Mr-A-urora/mini_wheel_legged_four/finished/主控陀螺仪校准.docx

1. Type_c连接主控,打开串口上位机（波特率随意）
2. 主控水平静止放置
3. 串口发送 imu set
4. 串口返回六个数据
5. 将六个数据复制粘贴到主控代码里

粘贴位置：Core\Work\BSP\BMI088\BMI088driver.h

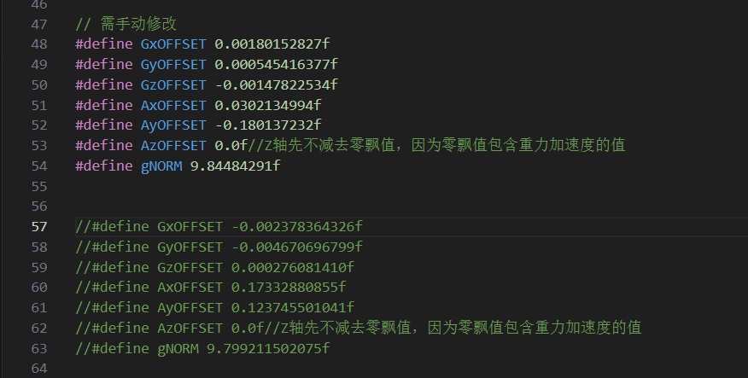
[picture p3: figure]
