Mr-A-urora/mini_wheel_legged_four/finished/hardware/主控.jpeg

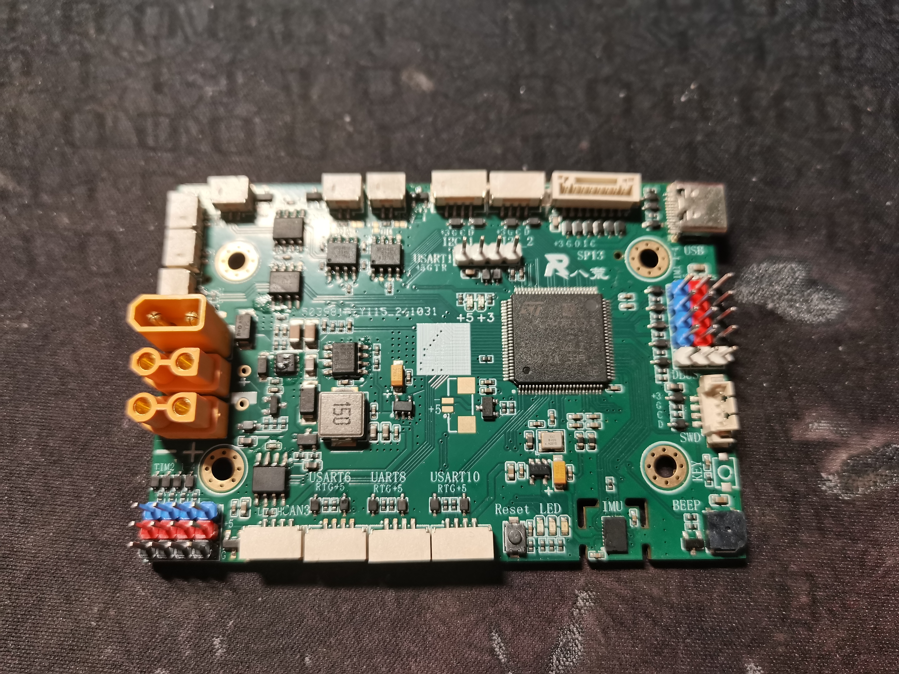
finished/hardware/主控.jpeg
