Mr-A-urora/mini_wheel_legged_four/finished/hardware/遥控器接收机.jpg

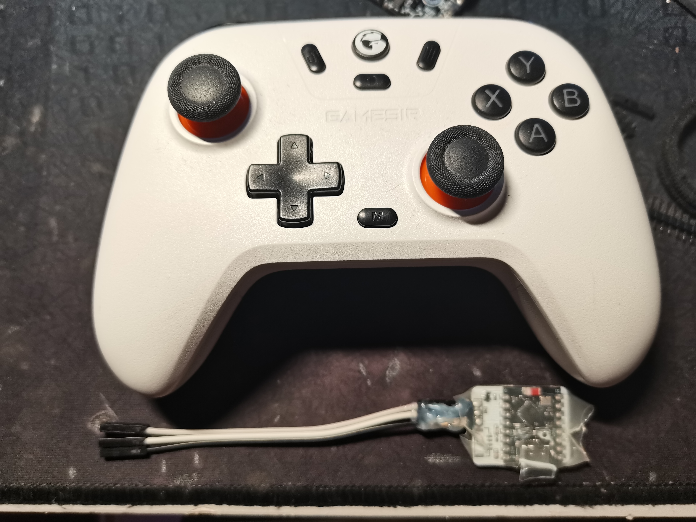
finished/hardware/遥控器接收机.jpg
