Mr-A-urora/mini_wheel_legged_four/finished/software/picture/imu_check.jpg

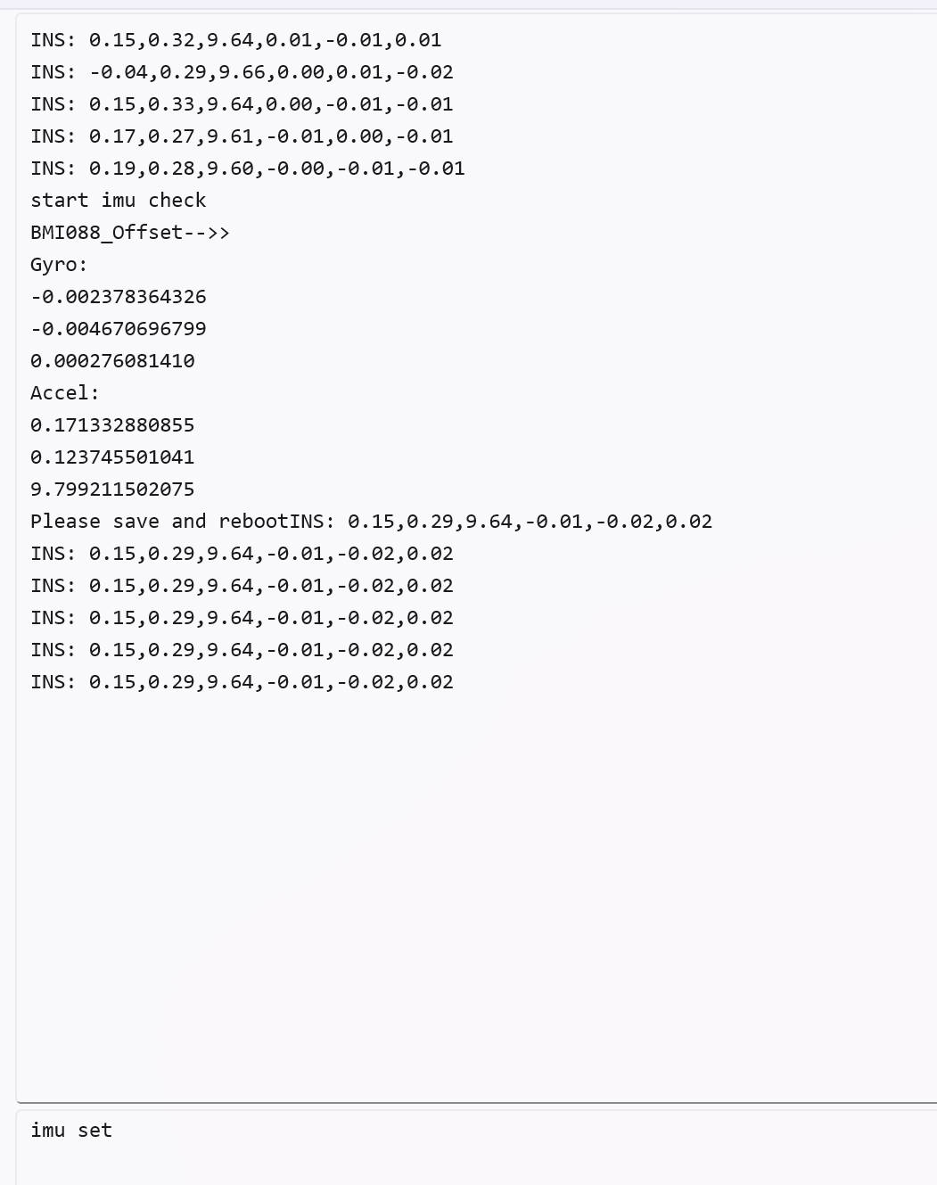
finished/software/picture/imu_check.jpg
