Mr-A-urora/mini_wheel_legged_four/finished/software/picture/Joint_Motor.jpg

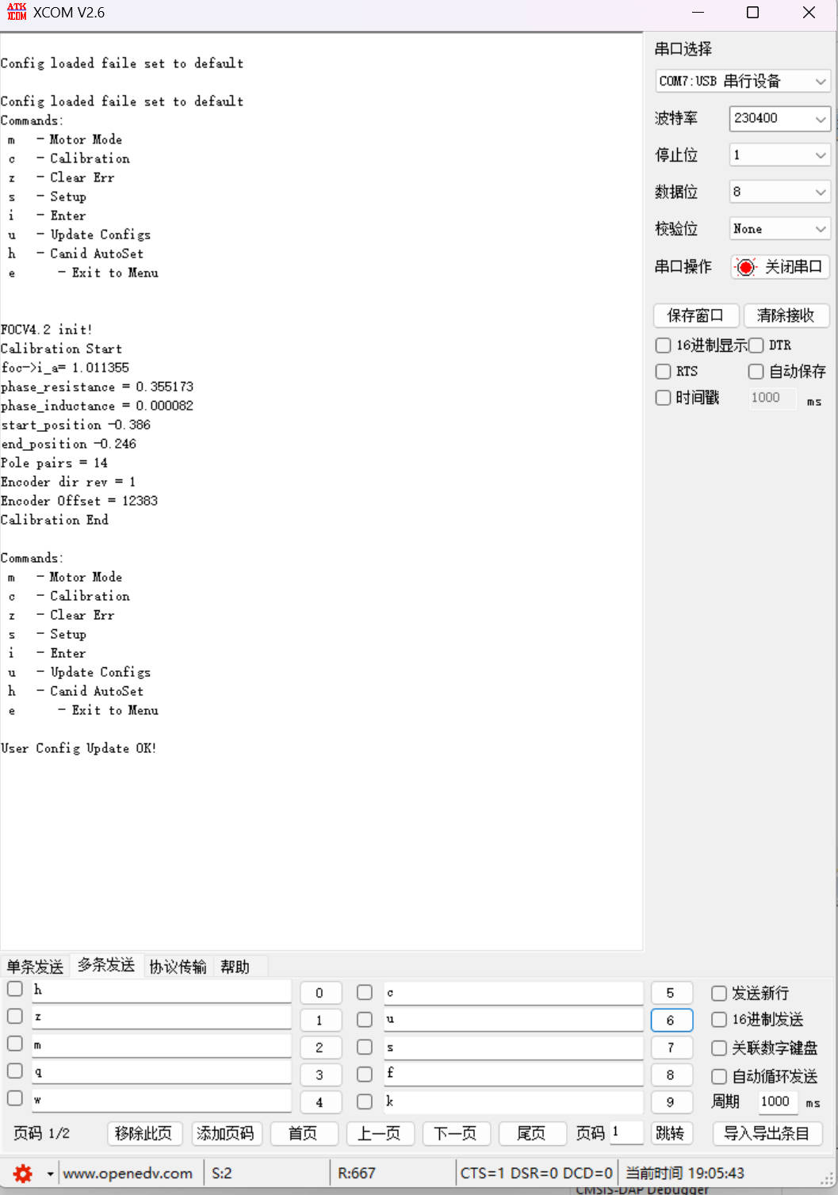
finished/software/picture/Joint_Motor.jpg
