Mr-A-urora/mini_wheel_legged_four/finished/software/Webots_word/worlds/.miniBH3.jpg

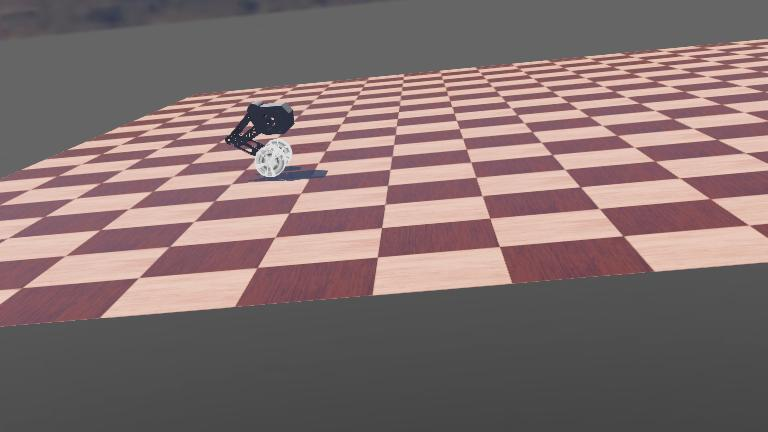
finished/software/Webots_word/worlds/.miniBH3.jpg
