Mr-A-urora/mini_wheel_legged_four/finished/机械/汽车兔.jpg

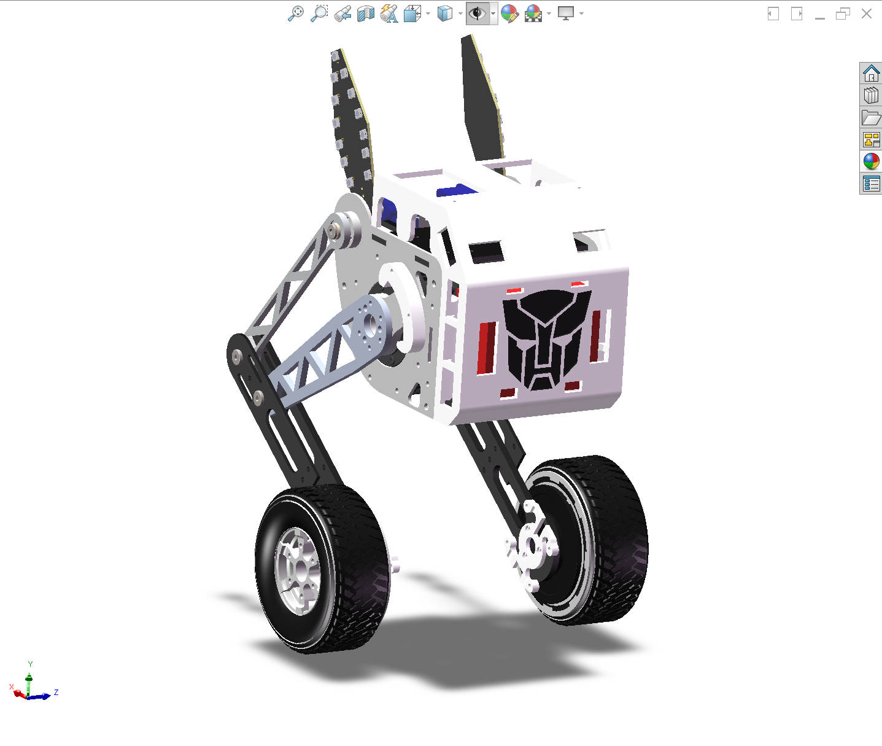
finished/机械/汽车兔.jpg
