Mr-A-urora/mini_wheel_legged_four/微信图片_2026-07-05_232406_757.jpg

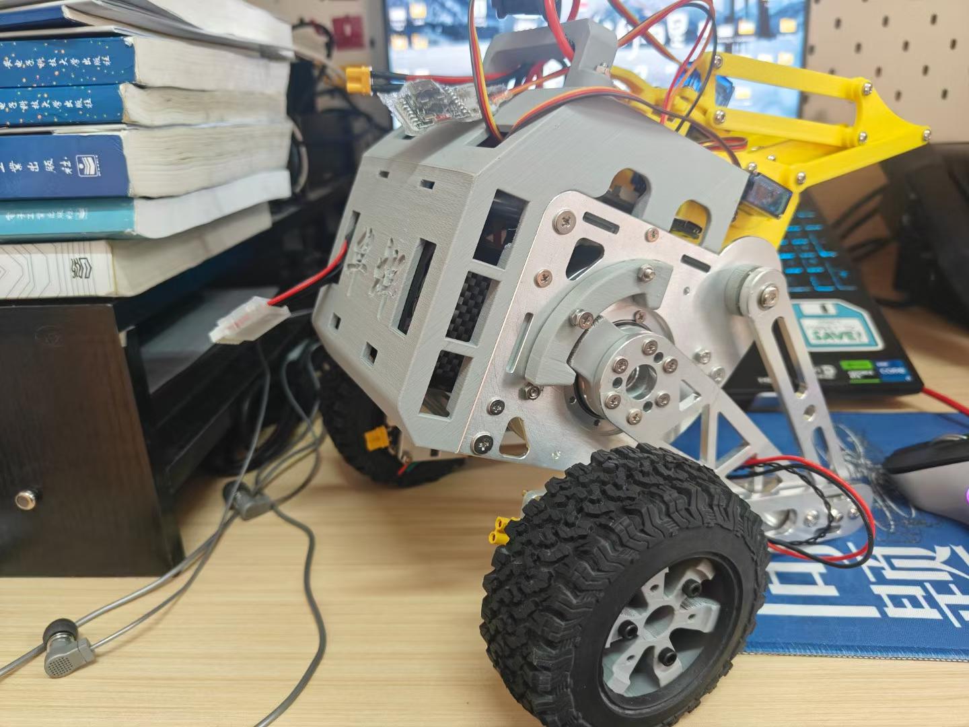
微信图片_2026-07-05_232406_757.jpg
