Mr-A-urora/mini_wheel_legged_four/finished/轮足BOM.xlsx

序号 | 分类 | 名称 | 规格 | 数量 | 单价 | 单独买价格 |  | 厂家 | 链接 | 备注
1 | 动力系统 | 髋关节电机 | GIM6010-8(不带外壳) | 2 | 299 | 598 | OK |  | GIM6010-8微型直流无刷减速马达外骨骼机械狗机器人关节驱动电机-淘宝网 (https://item.taobao.com/item.htm?abbucket=19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)
2 |  | 足关节电机 | 本末电机M601 | 2 | 20 | 40 | OK |  | 总线伺服无刷电机内置驱动器编码器机器人高精度驱动外转无刷电机-淘宝网 (https://item.taobao.com/item.htm?app=chrome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) | 咸鱼便宜
3 |  | 舵机 | SG90 | 2 | 5 | 10 | OK
4 | 电池 |  | 6S 1500mah | 1 | 93 | 93 | OK | 参数选择：1500ma/6S/xt30接头 | 航模锂电池3S/11.1V/2S/7.4V1100/2200/ 5200/7000mah4s5S/6S车模-淘宝网 (https://item.taobao.com/item.htm?id=527326501663)
5 | 螺丝等配件 |  | 板夹对锁螺丝M4-12 | 2 | 0.285 | 5.7 | OK |  | 304不锈钢对锁螺丝螺母倒边内六角子母对接螺栓家具连接夹板M3-M8-tmall.com天猫 (https://detail.tmall.com/item.htm?id=776035170505&skuId=5478631059368) | 螺丝带胶
6 |  |  | 板夹对锁螺丝M4-16 | 4 | 0.325 | 6.5 | OK |  | 304不锈钢对锁螺丝螺母倒边内六角子母对接螺栓家具连接夹板M3-M8-tmall.com天猫 (https://detail.tmall.com/item.htm?id=776035170505&skuId=5478631059368) | 锁紧小腿
7 |  |  | 直通尼龙套管5*3*8 | 8 | 0.014 | 2.83 | OK |  | 绝缘柱塑料垫片直通柱尼龙套管ABS垫高柱垫圈圆孔间隔柱MM3M4M5M6-tmall.com天猫 (https://detail.tmall.com/item.htm?id=631929683825&skuId=5539134544065) | 和M3*20，防松螺母一起锁紧小腿
8 |  |  | 平面推力轴承5*12*4 | 10 | 1.3 | 13 | OK |  | 微型平面推力球轴承F9-20 F10-18 F10-20 F12-20 F12-21 F12-23M-tmall.com天猫 (https://detail.tmall.com/item.htm?id=670324554959&sku_properties=122276018%3A20213)
9 |  |  | 法兰轴承MF95zz/5*9*3 | 6 | 1.3 | 7.8 | OK |  | 带挡边 法兰轴承 MF93 MF95 MF104 MF105 MF106 MF115 MF117 ZZ-tmall.com天猫 (https://detail.tmall.com/item.htm?id=659627230101&sku_properties=122276018%3A20213) | 锁紧小腿2X2,从动臂2
10 |  |  | 径向磁铁直径4厚度3 | 2 | 0.45 | 9 | OK |  | 径向强磁侧充磁x1*2 3 4 5 6小磁铁圆形感应强力磁钢编码器吸铁石-淘宝网 (https://item.taobao.com/item.htm?id=586809453889) | 轮毂电机使用（可配合打印件安装）
11 |  |  | 铝柱M4*100*10 | 3 | 1.2 | 9.6 | OK |  | 长螺母铝柱 10mm通孔铝柱 两头M4内牙 圆形铝柱 支撑铝棒治具配件-淘宝网 (https://item.taobao.com/item.htm?id=540111350105) | 链接两个侧板
12 |  |  | 扁平头M2*4 | 8 | 0 | 1 | OK |  | M1.4M2M2.5M3M4薄头CM机牙螺钉平头十字螺钉笔记本手机电子螺丝-tmall.com天猫 (https://detail.tmall.com/item.htm?id=589111930409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) | 固定6010的FOC板
13 |  |  | 扁平头M2*8 | 16 | 0 | 2 | OK |  | M1.4M2M2.5M3M4薄头CM机牙螺钉平头十字螺钉笔记本手机电子螺丝-tmall.com天猫 (https://detail.tmall.com/item.htm?id=589111930409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) | 肩垫4*2，固定舵机支架4,固定舵机4
14 |  |  | 扁平头M2.5*6 | 6 | 0 | 4 | OK |  | M1.4M2M2.5M3M4薄头CM机牙螺钉平头十字螺钉笔记本手机电子螺丝-tmall.com天猫 (https://detail.tmall.com/item.htm?id=589111930409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) | 轮毂
15 |  |  | 扁平头M3*6 | 20 | 0 | 2 | OK |  | M1.4M2M2.5M3M4薄头CM机牙螺钉平头十字螺钉笔记本手机电子螺丝-tmall.com天猫 (https://detail.tmall.com/item.htm?id=589111930409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) | 固定关节电机和侧板6*2，固定主板4*2
16 |  |  | 扁平头M3*8 | 10 | 0 | 2 | OK |  | M1.4M2M2.5M3M4薄头CM机牙螺钉平头十字螺钉笔记本手机电子螺丝-tmall.com天猫 (https://detail.tmall.com/item.htm?id=589111930409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) | 轮毂4*2，电池仓2
17 |  |  | 扁平头M3*14 | 22 | 0 | 3.2 | OK |  | 304不锈钢薄平头内六角螺丝CM沉头螺栓扁平头机螺钉M2M3M4M5M6M8-tmall.com天猫 (https://detail.tmall.com/item.htm?id=643247726540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) | 固定关节限位2X2,固定6010的轴6X2，电池仓2x2,把手2
18 |  |  | M4*10 | 6 | 0 | 3.5 | OK |  | 304不锈钢薄平头内六角螺丝CM沉头螺栓扁平头机螺钉M2M3M4M5M6M8-tmall.com天猫 (https://detail.tmall.com/item.htm?id=643247726540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) | 固定铝柱
19 |  |  | M3*20 | 8 | 0 | 4.5 | OK |  | 304不锈钢薄平头内六角螺丝CM沉头螺栓扁平头机螺钉M2M3M4M5M6M8-tmall.com天猫 (https://detail.tmall.com/item.htm?id=643247726540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) | 和尼龙，防松螺母一起锁紧小腿
20 |  |  | M3*18 | 6 | 0 | 4.2 | OK |  | 304不锈钢薄平头内六角螺丝CM沉头螺栓扁平头机螺钉M2M3M4M5M6M8-tmall.com天猫 (https://detail.tmall.com/item.htm?id=643247726540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) | （可选）轮毂
21 |  |  | M2螺母 | 4 |  | 1.5 | OK |  | 304不锈钢螺母螺帽螺丝帽外六角螺母帽M2M3M4M5M6M8M10M12M14M16-tmall.com天猫 (https://detail.tmall.com/item.htm?id=40017837495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) | 固定舵机支架
22 |  |  | M3螺母（防松） | 10 | 0 | 2.8 | OK |  | 304不锈钢六角防松螺母201锁紧螺帽316防松螺丝帽M2M3M4M5M6M8M24-tmall.com天猫 (https://detail.tmall.com/item.htm?abbucket=6&id=40003646337&rn=8702b06da3fc64e99faa52137dfcca44) | 把手2，小腿固定4X2
23 |  |  | 注塑铜螺母M3*3*4.5 | 4 |  | 1.62 | OK |  | 注塑铜螺母M2M2.5铜预埋件M3M4镶嵌件M5M6滚花螺母铜花母M8英制-tmall.com天猫 (https://detail.tmall.com/item.htm?id=635518708353)
24 |  |  | M3铜柱5+8 | 4 |  | 1.8 | OK | 0 | 六角铜柱M3M4M5M6单头铜螺柱机箱主板螺丝柱铜柱隔离柱支柱M2M2.5-tmall.com天猫 (https://detail.tmall.com/item.htm?id=19634185206) | 固定轮毂FOC
25 |  |  | M3双通铜柱8mm长度 | 4 |  | 2.6 | OK |  | 铜柱双通六角铜柱M3M4隔离柱机箱主板线路板螺柱铜螺柱空心螺母柱-tmall.com天猫 (https://detail.tmall.com/item.htm?id=588307625790) | 垫高主板
26 | 轮胎 | 轮胎 |  | 2 | 10 | 20 | OK | 模型你我天地（选择92MM-A） | 1.9寸 90MM 96MM 102MM 108MM 117MM攀爬轮胎 CC01 T4 超强抓地力-淘宝网 (https://item.taobao.com/item.htm?id=645393968881)
27 | 机械结构 | CNC |  | 12 | 0 | 98 | OK | 铨州 |  | 80+18
28 |  | 3D打印(FDM) |  | 1 | 65 | 65 |  |  |  | 320g左右
29 |  | 底板（碳纤维、玻纤） |  | 1 | 10 | 10
30 | 电路板 | FOC板 | 贴装好的 | 4 | 99 | 396 | OK
31 |  | 主控板 | 贴装好的 | 1 | 199 | 199 | OK
32 |  | 耳朵 | 贴装好的 | 2 | 5 | 10
33 | 线束 | CAN延长线1 | 双绞/25cm/反序 | 2 | 0.56 | 1.12 | OK |  |  | 从髋关节电机到足关节电机
34 |  | CAN延长线2 | 双绞/15cm/反序 | 2 | 0.4 | 0.8 | OK |  |  | 从主控到髋关节电机
35 |  | 电源延长线1 | 16AWG/15cm/两头XT30公转母 | 2 | 6 | 12+运费 | OK |  |  | 从髋关节电机到足关节电机
36 |  | 电源延长线1 | 20AWG/25cm/两头XT30公转母 | 2 | 6 | 12+运费 |  |  |  | 从主控到髋关节电机
37 |  | 硅胶线 | 20AWG/10cm | 6 |  | 5 | OK |  |  | 改装轮子电机，最好是三种颜色
38 | 遥控系统 | 小鸡遥控器 |  | 1 | 79.9 |  | OK | 盖世小鸡旗舰店 | 盖世小鸡启明星无线游戏手柄pc电脑版steam霍尔xbox模式蓝牙手柄switch2手柄安卓手机特斯拉双影奇境怪物猎人-tmall.com天猫 (https://detail.tmall.com/item.htm?from=cart&id=749611763829&skuId=5169816701870) | 抢券便宜
39 |  | ESP32接收器 | esp32c3supermini+铝基板+焊接 | 1 | 30 | 30
40 | 自备配件 | STLINK | 自备线束 |  |  |  | OK
41 |  | 6S充电器 |  |  |  |  | OK
42 |  | BB响 |  |  |  |  | OK
43 |  | 电烙铁 | 改装M601电机，加热热熔螺母 |  |  |  | OK
44 |  | 多种螺丝刀 |  |  |  |  | OK
45 |  | 热缩管 | 热缩管1.5mm/1m长度 |  |  |  | OK
 |  | 杜邦线 |  |  |  |  | OK
 |  | 螺丝防松胶 |  |  |  |  |  |  |  | 防止关节对锁螺丝松动
 |  | 电池延长线，带船型开关 | 强烈建议，接到电池上，注意安全！！！
46
47
48
49 |  |  |  |  |  | 1667.07
 |  |  |  | 总价
