Mr-A-urora/mini_wheel_legged_four/finished/机械/采购BOM.xlsx

名称 | 数量 | 备注
GIM6010 | 2
GIM6010外壳 | 2
轮子 | 2
轮毂电机 | 2
主控 | 1
6s电池 | 1
铨州腿 | 12
螺丝螺母 | 1
3d打印件 | 1
电驱 | 4
耳朵 | 2
舵机 | 2
主控（亚克力）支架 | 1
成本预估1.3~1.4K
92mm越野车轮胎 | 2
板夹对锁螺丝M4-12 | 2
板夹对锁螺丝M4-16 | 4
直通尼龙套管5*3*8 | 6
平面推力轴承5*12*4 | 10
法兰轴承MF95zz/5*9*3 | 6
径向磁铁直径4厚度3 | 2
铝柱M4*100*10 | 3
螺丝螺母
扁平头M2*8 | 4*2+6 | 肩垫
扁平头M2.5*6 | 3*2 | 轮毂
扁平头M3*6 | 6*2+8 | 关节电机+主板固定
扁平头M3*8 | 4*2+2 | 轮毂
扁平头M3*14 | 8*2+2*2+1*2 | 关节+电池仓+把手
M4*10 | 3*2 | 头部侧板
M3*20 | 4*2 | 腿部
M3*18 | 3*2 | （可选）轮毂
M3螺母（防松） | 4*2+2 | 腿部+电池仓
M3铜螺柱5+8 | 4*2 | 轮毂
注塑铜螺母M3*3*4.5 | 4 | 电池仓
双通螺柱M3*8 | 4 | 主板
