Mr-A-urora/mini_wheel_legged_four/finished/MeArm机械臂图纸，内含part、step、stp、stl/MeArm机械臂STP(装配)/装配体1.SLDASM

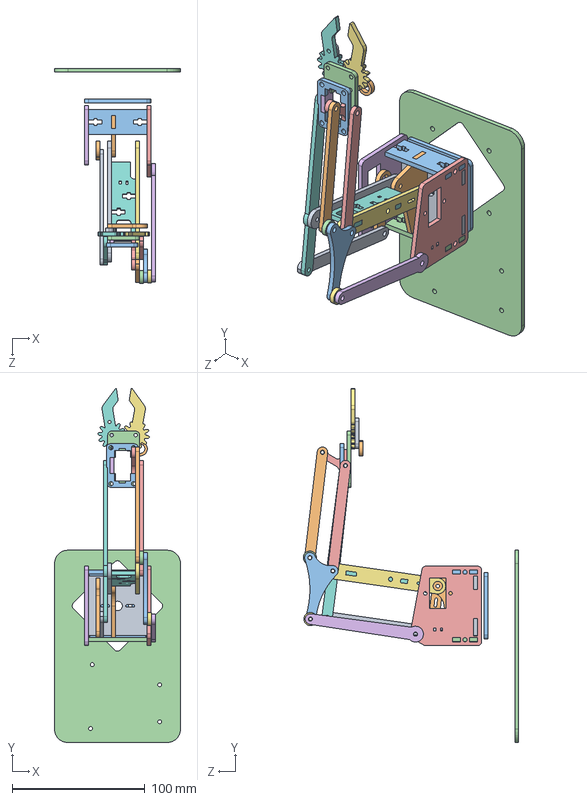
[picture p12: CAD file, 2026-03-29]
finished/MeArm机械臂图纸，内含part、step、stp、stl/MeArm机械臂STP(装配)/装配体1.SLDASM
95.0 x 266.9 x 162.5 mm
转台底座
大臂安装座
转台挡板1
转台挡板2
转台侧壁1
转台侧壁2
大臂副
大臂支撑
大臂主
小臂1
前臂角动件
垫片1 - 副本 (2)
小臂2
后壁
垫片1
前臂
小臂3
后力臂
钳子舵机安装板
钳子舵机安装座
钳子角动件
钳子与前臂连接件
钳子1
钳子2
钳子传动件
钳子力臂
底座电机安装座
底座
