Mr-A-urora/mini_wheel_legged_four/finished/机械/3d打印/舵机力臂.SLDASM.STEP

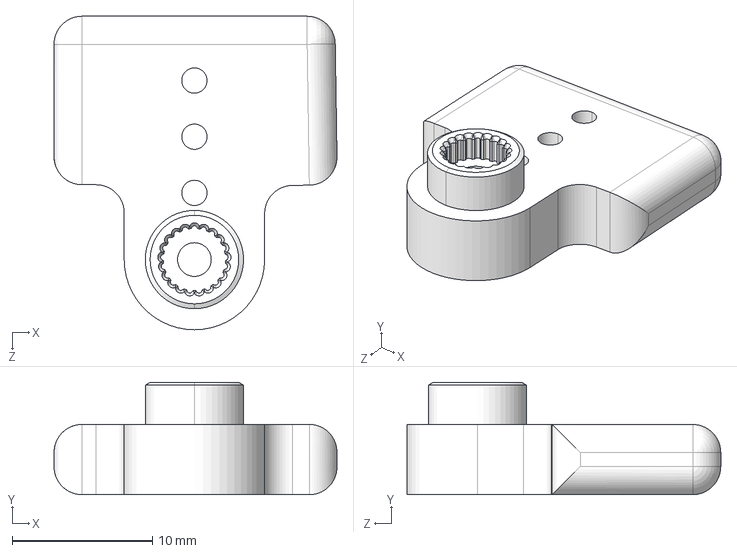
[picture p13: CAD file, 2026-03-29]
finished/机械/3d打印/舵机力臂.SLDASM.STEP
20.2 x 8.00 x 22.3 mm
