Mr-A-urora/mini_wheel_legged_four/finished/机械/led_ear.SLDASM

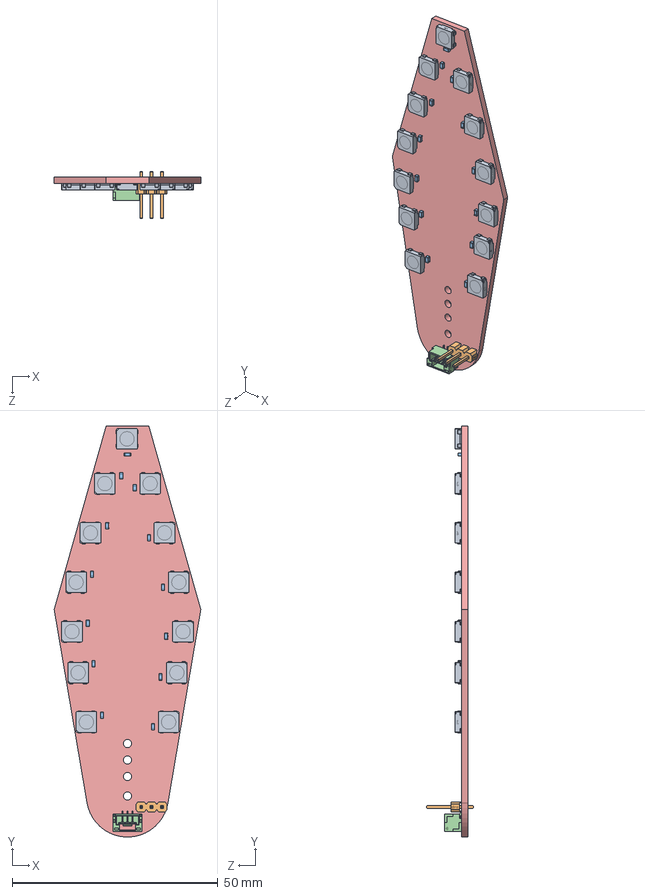
[picture p14: CAD file, 2026-03-29]
finished/机械/led_ear.SLDASM
35.7 x 100.0 x 11.5 mm
COMPOUND.step x 13
SOLID.step
SOLID-0.step x 13
COMPOUND-1.step
Board.step
