Mr-A-urora/mini_wheel_legged_four/finished/机械/6010-8安装尺寸图20240313.SLDASM

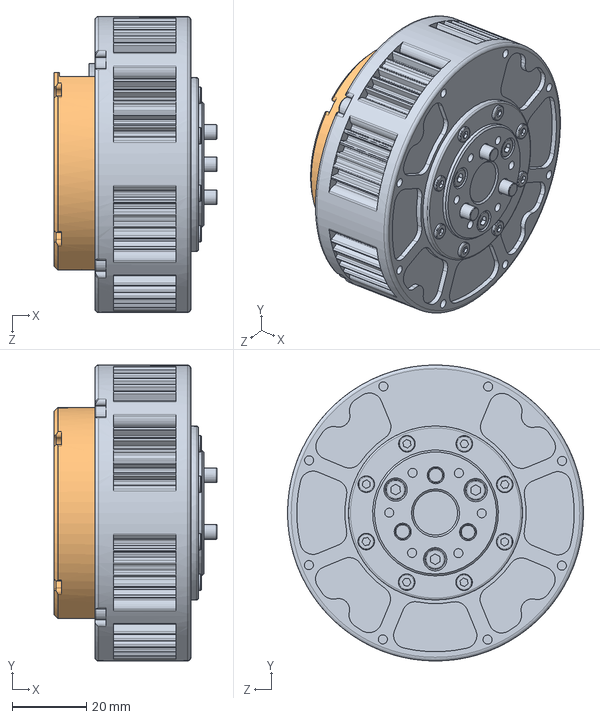
[picture p15: CAD file, 2026-03-29]
finished/机械/6010-8安装尺寸图20240313.SLDASM
44.0 x 80.0 x 80.0 mm
