Mr-A-urora/mini_wheel_legged_four/finished/机械/轮胎.SLDASM

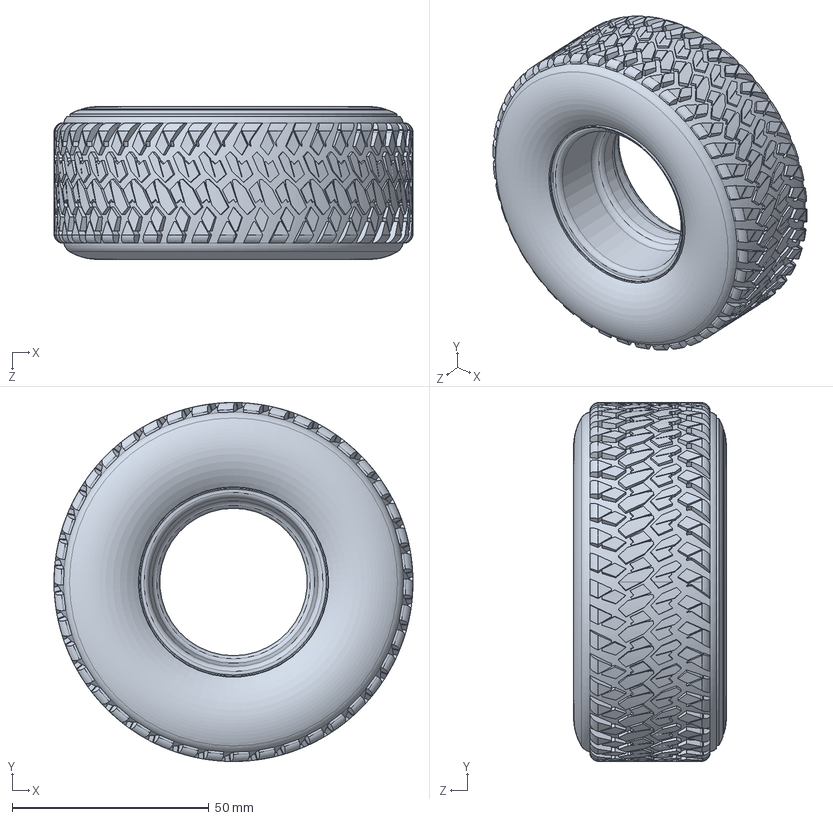
[picture p16: CAD file, 2026-03-29]
finished/机械/轮胎.SLDASM
91.3 x 91.3 x 38.8 mm
