Mr-A-urora/mini_wheel_legged_four/finished/机械/3D_PCB1_2025-02-07.SLDASM

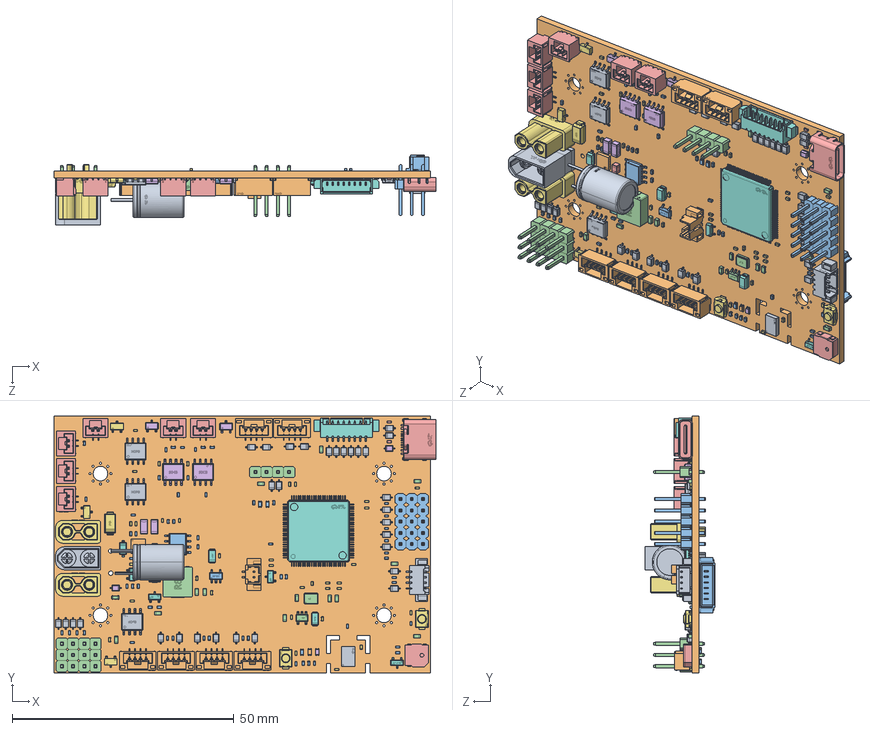
[picture p17: CAD file, 2026-03-29]
finished/机械/3D_PCB1_2025-02-07.SLDASM
86.2 x 58.0 x 15.9 mm
COMPOUND.step-1.STEP
COMPOUND-0.step.STEP
COMPOUND-1.step-1.STEP
COMPOUND-2.step.STEP
COMPOUND-3.step.STEP x 6
COMPOUND-4.step.STEP x 2
COMPOUND-5.step.STEP
COMPOUND-6.step.STEP x 4
COMPOUND-7.step.STEP
COMPOUND-8.step.STEP
COMPOUND-9.step.STEP
COMPOUND-10.step.STEP x 4
COMPOUND-11.step.STEP
COMPOUND-12.step.STEP x 2
COMPOUND-13.step.STEP x 3
COMPOUND-14.step.STEP
COMPOUND-15.step.STEP x 3
COMPOUND-16.step.STEP
COMPOUND-17.step.STEP x 3
COMPOUND-18.step.STEP
COMPOUND-19.step.STEP x 2
COMPOUND-20.step.STEP
COMPOUND-21.step.STEP x 2
COMPOUND-22.step.STEP x 2
COMPOUND-23.step.STEP
rdI3-Board.step.STEP
rdI3-R1-R0402.step.STEP x 61
rdI3-C25-C0603_1.step.STEP x 8
rdI3-C26-C0805.step.STEP
rdI3-D14-SOT-23-3_L2.9-W1.6-P1.90-LS2.8-BR.step.STEP x 2
rdI3-C27-C0402.step.STEP x 37
rdI3-D17-SOD-123_L2.8-W1.8-LS3.7-RD.step.STEP
rdI3-U32-SOD-323_L1.8-W1.3-LS2.7-BI.step.STEP x 31
rdI3-U26-PDFN-8_L3.3-W3.3-P0.65-BL.step.STEP
rdI3-U9-ESOP-8_L4.9-W3.9-P1.27-LS6.0-TL-EP.step.STEP
rdI3-FB1-L0603.step.STEP x 6
rdI3-BUZZER1-BUZ-SMD_L5.0-W5.5-P4.60.step.STEP
rdI3-C53-C1206.step.STEP x 2
rdI3-U41-CONN-TH_XT30U-F.step.STEP x 2
rdI3-U17-LQFP-100_L14.0-W14.0-P0.50-LS16.0-BL.step.STEP
rdI3-C69-cap-th_bd10.0-p5.00-d0.6-fd.step.STEP
rdI3-J1-CONN-SMD_4P-P1.25_GH1.25-4PLI.step.STEP x 6
rdI3-H1-HDR-TH_5P-P2.54-V-F.step.STEP x 3
rdI3-X1-OSC-SMD_4P-L3.2-W2.5-BL.step.STEP
