Mr-A-urora/mini_wheel_legged_four/finished/MeArm机械臂图纸，内含part、step、stp、stl/MeArm机械臂DXF/MeArm切割图纸1：2.dxf

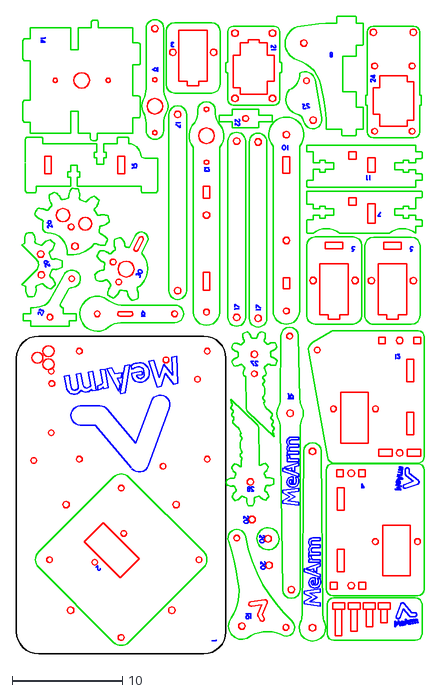
[picture p18: CAD file, 2026-03-29]
finished/MeArm机械臂图纸，内含part、step、stp、stl/MeArm机械臂DXF/MeArm切割图纸1：2.dxf
37.0 x 57.8
