Mr-A-urora/mini_wheel_legged_four/finished/MeArm机械臂图纸，内含part、step、stp、stl/MeArm机械臂PART/钳子力臂.SLDPRT

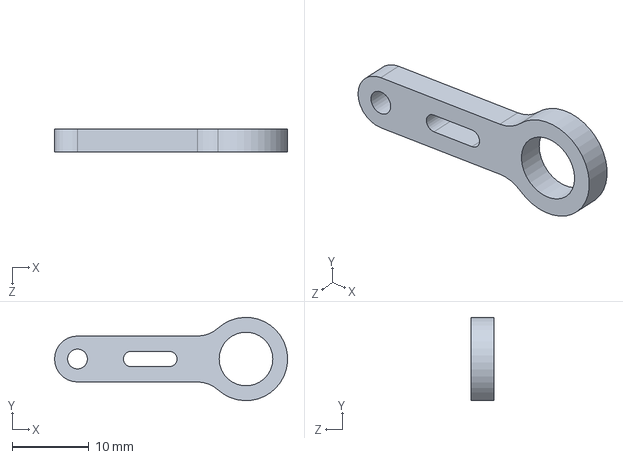
[picture p19: CAD file, 2026-03-29]
finished/MeArm机械臂图纸，内含part、step、stp、stl/MeArm机械臂PART/钳子力臂.SLDPRT
30.4 x 10.9 x 3.00 mm
