Mr-A-urora/mini_wheel_legged_four/finished/MeArm机械臂图纸，内含part、step、stp、stl/MeArm机械臂STL（新版）/小臂1.STL

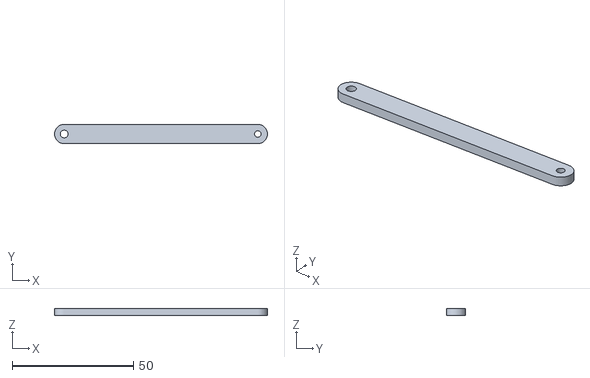
[picture p20: CAD file, 2026-03-29]
finished/MeArm机械臂图纸，内含part、step、stp、stl/MeArm机械臂STL（新版）/小臂1.STL
88.0 x 8.00 x 3.00
