Mr-A-urora/mini_wheel_legged_four/finished/机械/3d打印/树脂-舵机支架.STEP

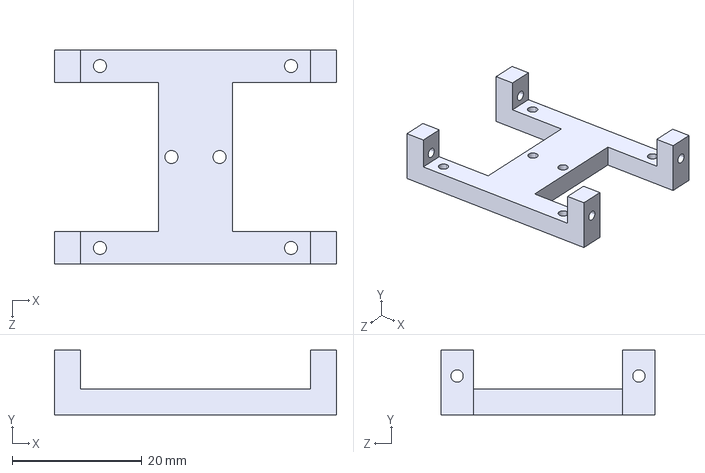
[picture p21: CAD file, 2026-03-29]
finished/机械/3d打印/树脂-舵机支架.STEP
43.4 x 10.0 x 33.0 mm
