Mr-A-urora/mini_wheel_legged_four/finished/机械/M63A_111/M0603A_111_3d.STEP

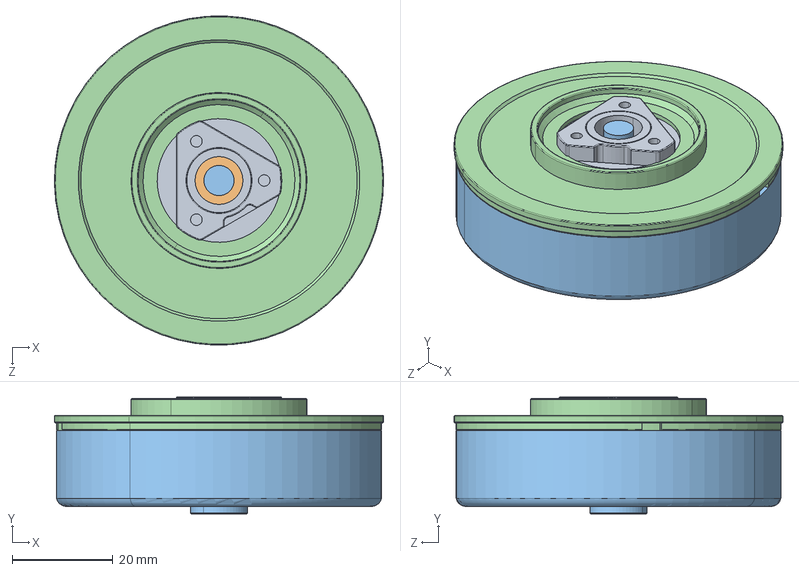
[picture p22: CAD file, 2026-03-29]
finished/机械/M63A_111/M0603A_111_3d.STEP
65.5 x 23.2 x 65.5 mm
隅赽
BM.WJ.AC00019.01 M0603A_111 粣創 x 2
蛌赽
綴裔
