Mr-A-urora/mini_wheel_legged_four/finished/机械/轴承5-12-4.SLDPRT

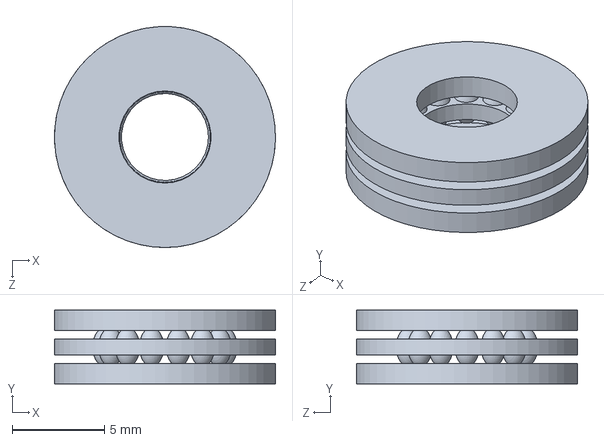
[picture p23: CAD file, 2026-03-29]
finished/机械/轴承5-12-4.SLDPRT
12.0 x 4.00 x 12.0 mm
