Mr-A-urora/mini_wheel_legged_four/finished/机械/铨州/铝合金轮毂驱动支架.STEP

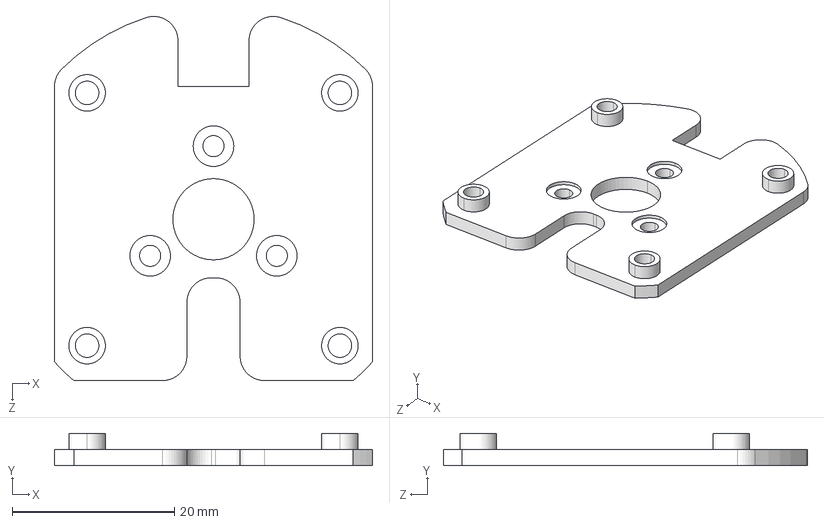
[picture p24: CAD file, 2026-03-29]
finished/机械/铨州/铝合金轮毂驱动支架.STEP
39.1 x 4.00 x 44.8 mm
