Mr-A-urora/mini_wheel_legged_four/finished/MeArm机械臂图纸，内含part、step、stp、stl/MeArm机械臂PART/大臂副.SLDPRT

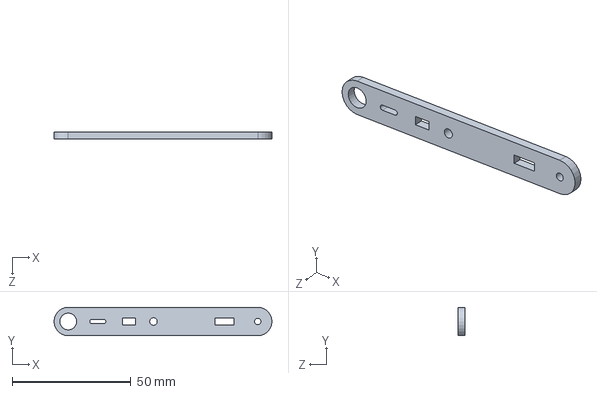
[picture p25: CAD file, 2026-03-29]
finished/MeArm机械臂图纸，内含part、step、stp、stl/MeArm机械臂PART/大臂副.SLDPRT
92.0 x 12.0 x 3.00 mm
