Mr-A-urora/mini_wheel_legged_four/finished/MeArm机械臂图纸，内含part、step、stp、stl/MeArm机械臂STL（新版）/转台挡板1.STL

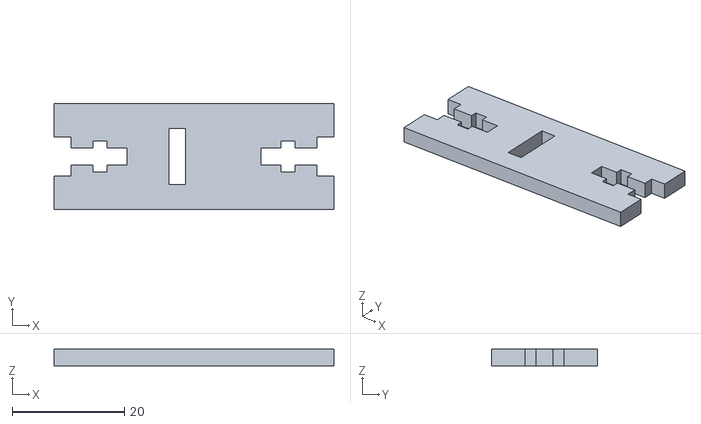
[picture p26: CAD file, 2026-03-29]
finished/MeArm机械臂图纸，内含part、step、stp、stl/MeArm机械臂STL（新版）/转台挡板1.STL
50.0 x 19.0 x 3.00
