Mr-A-urora/mini_wheel_legged_four/finished/机械/3d打印/树脂-关节垫.STEP

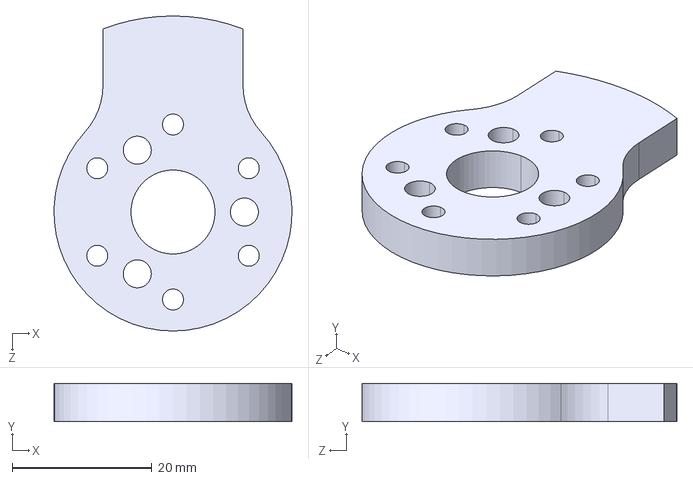
[picture p27: CAD file, 2026-03-29]
finished/机械/3d打印/树脂-关节垫.STEP
34.0 x 5.50 x 45.0 mm
