Mr-A-urora/mini_wheel_legged_four/finished/机械/电池仓.SLDPRT

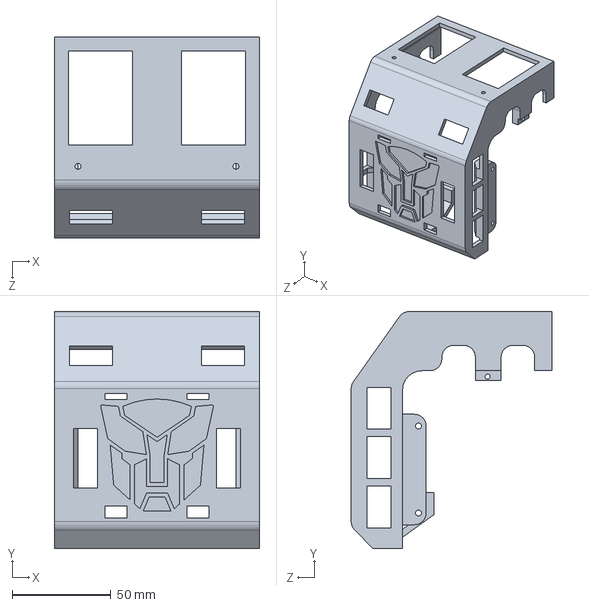
[picture p28: CAD file, 2026-03-29]
finished/机械/电池仓.SLDPRT
104.0 x 120.0 x 101.6 mm
