Mr-A-urora/mini_wheel_legged_four/finished/机械/铨州/l2.STEP

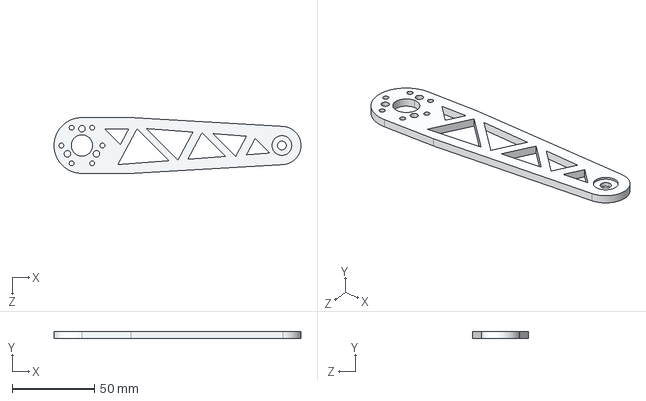
[picture p29: CAD file, 2026-03-29]
finished/机械/铨州/l2.STEP
150.3 x 4.00 x 34.0 mm
