Mr-A-urora/mini_wheel_legged_four/finished/MeArm机械臂图纸，内含part、step、stp、stl/MeArm机械臂PART/钳子1.SLDPRT

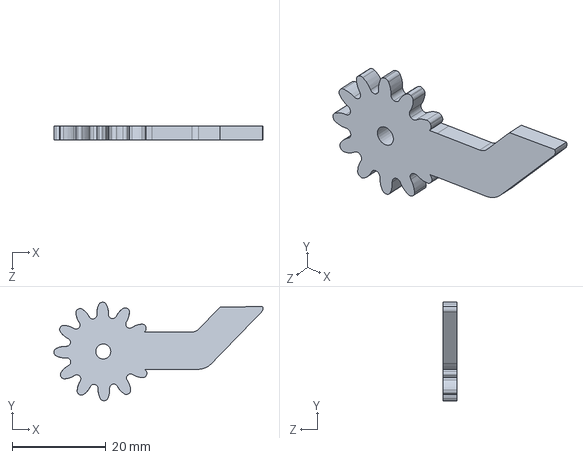
[picture p30: CAD file, 2026-03-29]
finished/MeArm机械臂图纸，内含part、step、stp、stl/MeArm机械臂PART/钳子1.SLDPRT
44.5 x 21.0 x 3.00 mm
