Mr-A-urora/mini_wheel_legged_four/finished/机械/foc驱动.step

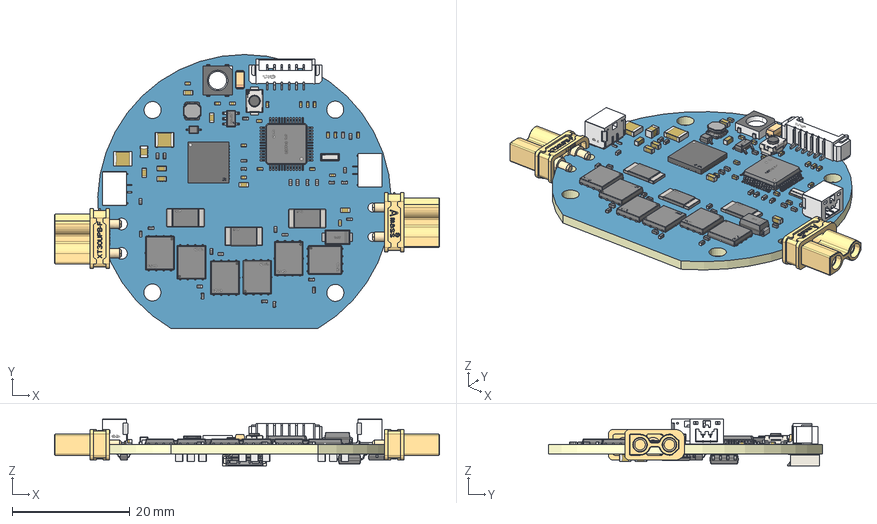
[picture p31: CAD file, 2026-03-29]
finished/机械/foc驱动.step
65.5 x 46.6 x 7.95 mm
Board~sRYJ
TopCopper~sRYJ
BottomCopper~sRYJ
TopFpcStiffener~sRYJ
BottomFpcStiffener~sRYJ
OSC-SMD_3P-L3.2-W1.3-P1.20-L~OSC-SMD_3P-L3.2-W1.3-H0.8-P1.2~sRYJ
L0402~L0402_L1.0-W0.5-H0.5_BEAD~sRYJ
IND-SMD_L3.0-W3.0~IND-SMD_L3.0-W3.0-H1.5~sRYJ
VQFN-48_L7.0-W7.0-P0.50-TL-EP5.1~VQFN-48_L7.0-W7.0-P0.50-TL-EP5.1~sRYJ
PDFN-8_L5.8-W4.9-P1.27-LS6.1-BL~PDFN-8_L5.8-W4.9-P1.27-LS6.1-BL~sRYJ x 6
SOD-323_L1.6-W1.3-LS2.7-RD~SOD-323_L1.6-W1.3-LS2.7-RD~sRYJ
CONN-SMD_6P-P1.25_XUNPU_WAFER-MX1.25-6PWB~CONN-SMD_6P-P1.25_XUNPU_ WAFER-MX1.25-6PWB~sRYJ
LQFP-48_L7.0-W7.0-P0.50-LS9.0-BL~LQFP-48_ L7.0-W7.0-H1.4-LS9.0-P0.50~sRYJ
LED-SMD_4P-L5.0-W5.0-TL_WS2812B-B~LED-SMD_4P-L5.0-W5.0-H1.57-TL_ WS2812B-B~sRYJ
RES-SMD_L6.4-W3.2-1~RES-SMD_L6.4-W3.2-1~sRYJ x 3
CONN-TH_2P-P1.25_XUNPU_WAFER-GH1.25-2PWB~CONN-TH_2P-P1.25_XUNPU_ WAFER-GH1.25-2PWB~sRYJ x 2
SOT-23-5_L3.0-W1.7-P0.95-LS2.8-BR~SOT-23-5_ L2.9-W1.6-H1.1-LS2.8-P0.95~sRYJ
C0805~C0805_L2.0-W1.3-H1.3~sRYJ x 10
CONN-TH_XT30UPB-F~CONN-TH_XT30UPB-F~sRYJ x 2
FPC-SMD_8P-P0.50_XUNPU_FPC-05FB-8PH20~FPC-SMD_8P-P0.50_XUNPU_ FPC-05FB-8PH20~sRYJ
C1210~C1210_L3.2-W2.5-H0.9~sRYJ x 2
CAP-SMD_L3.2-W1.6-RD-C7171~CASE-A_L3.2-W1.6-H1.6~sRYJ
C0603~C0603_L1.6-W0.8-H0.8~sRYJ x 7
SW-SMD_L3.9-W3.0-P4.45~SW-SMD_L3.9-W2.9-H2.0-LS4.8~sRYJ
C0402~C0402_L1.0-W0.5-H0.5~sRYJ x 18
SOT-23_L2.9-W1.3-P1.90-LS2.4-BR~SOT-23-3P_ L2.9-W1.3-H1.0-LS2.4-P0.95~sRYJ x 2
R0402~R0402_L1.0-W0.5-H0.5~sRYJ x 27
SOIC-8_L5.0-W4.0-P1.27-LS6.0-BL~SOIC-8_L4.9-W3.9-H1.7-LS6.0-P1.27~sRYJ
TSSOP-14_L5.0-W4.4-P0.65-LS6.4-BL~TSSOP-14_ L5.0-W4.4-H1.0-LS6.4-P0.65~sRYJ
SMA_L4.4-W2.6-LS5.0-BI~SMA_L4.3-W2.5-H2.1-LS5.0~sRYJ
