Mr-A-urora/mini_wheel_legged_four/finished/机械/铨州/l3.STEP

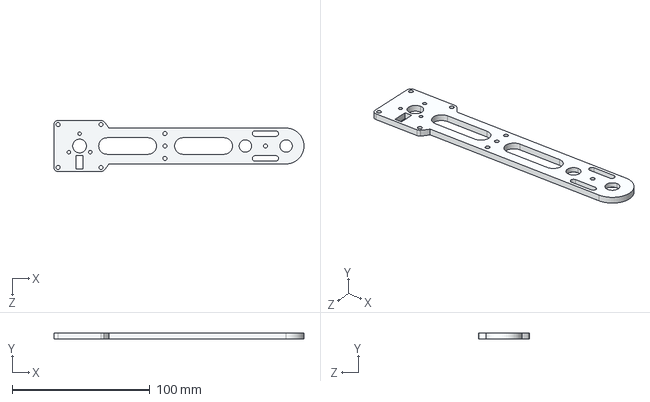
[picture p32: CAD file, 2026-03-29]
finished/机械/铨州/l3.STEP
181.6 x 4.00 x 37.1 mm
