Mr-A-urora/mini_wheel_legged_four/finished/MeArm机械臂图纸，内含part、step、stp、stl/MeArm机械臂STP(装配)/舵机.SLDPRT

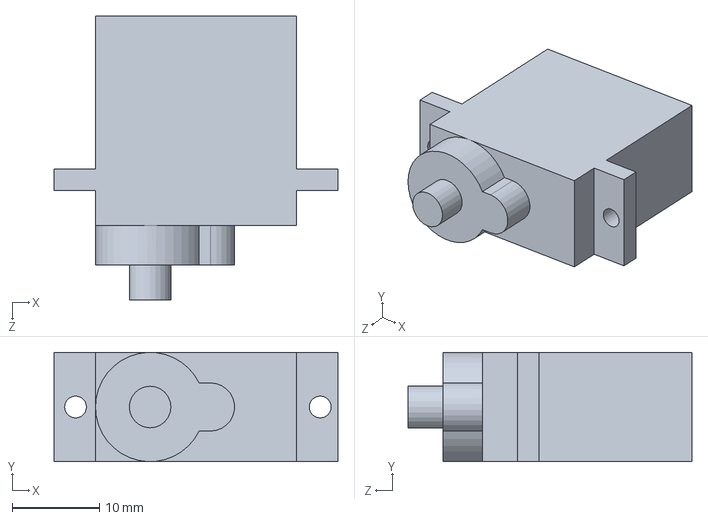
[picture p33: CAD file, 2026-03-29]
finished/MeArm机械臂图纸，内含part、step、stp、stl/MeArm机械臂STP(装配)/舵机.SLDPRT
32.5 x 12.5 x 32.5 mm
