Mr-A-urora/mini_wheel_legged_four/finished/机械/螺丝/M2.5_6.SLDPRT

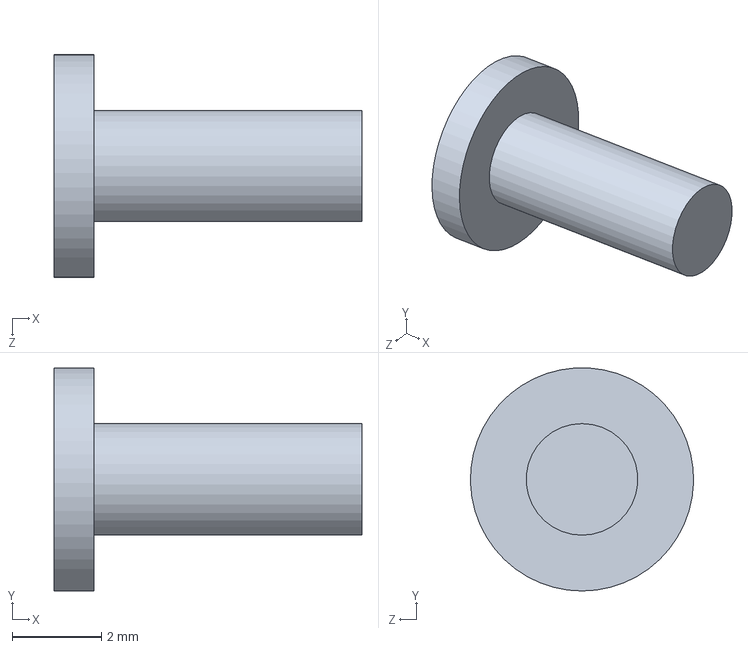
[picture p34: CAD file, 2026-03-29]
finished/机械/螺丝/M2.5_6.SLDPRT
6.90 x 4.99 x 5.00 mm
