Mr-A-urora/mini_wheel_legged_four/finished/机械/铨州/L3-2.STEP

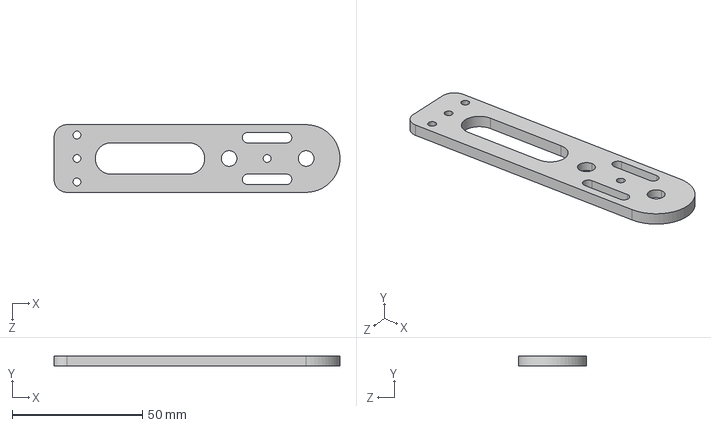
[picture p35: CAD file, 2026-03-29]
finished/机械/铨州/L3-2.STEP
109.8 x 4.00 x 26.0 mm
