Mr-A-urora/mini_wheel_legged_four/finished/MeArm机械臂图纸，内含part、step、stp、stl/MeArm机械臂PART/钳子与前臂连接件.SLDPRT

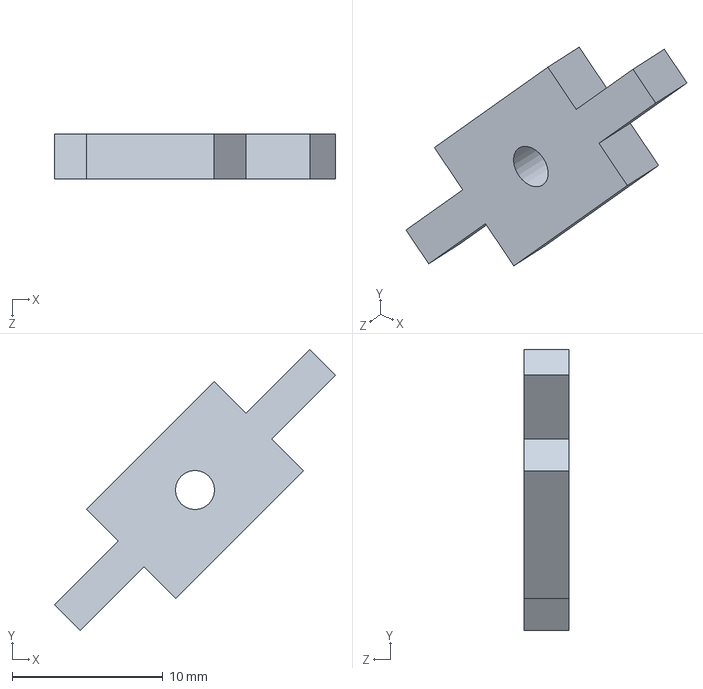
[picture p36: CAD file, 2026-03-29]
finished/MeArm机械臂图纸，内含part、step、stp、stl/MeArm机械臂PART/钳子与前臂连接件.SLDPRT
18.7 x 18.7 x 3.00 mm
