Mr-A-urora/mini_wheel_legged_four/finished/机械/3-5-8隔离柱.SLDPRT

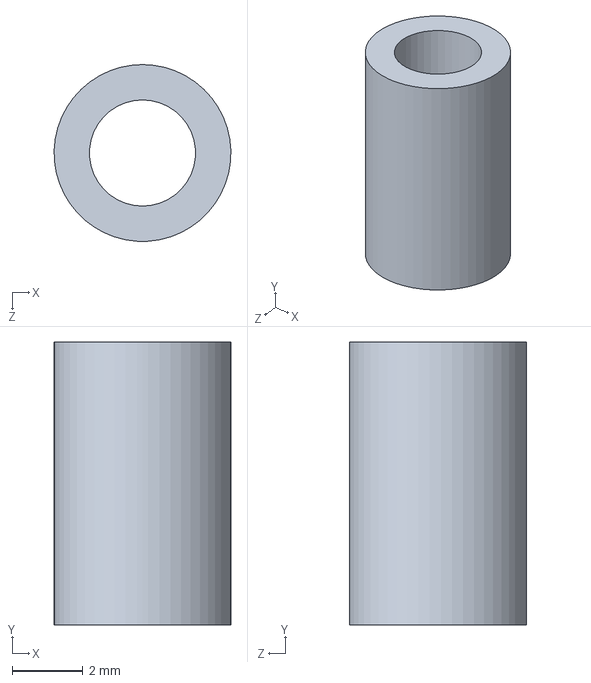
[picture p37: CAD file, 2026-03-29]
finished/机械/3-5-8隔离柱.SLDPRT
5.00 x 8.00 x 5.00 mm
