Mr-A-urora/mini_wheel_legged_four/finished/机械/3d打印/轮毂.STEP

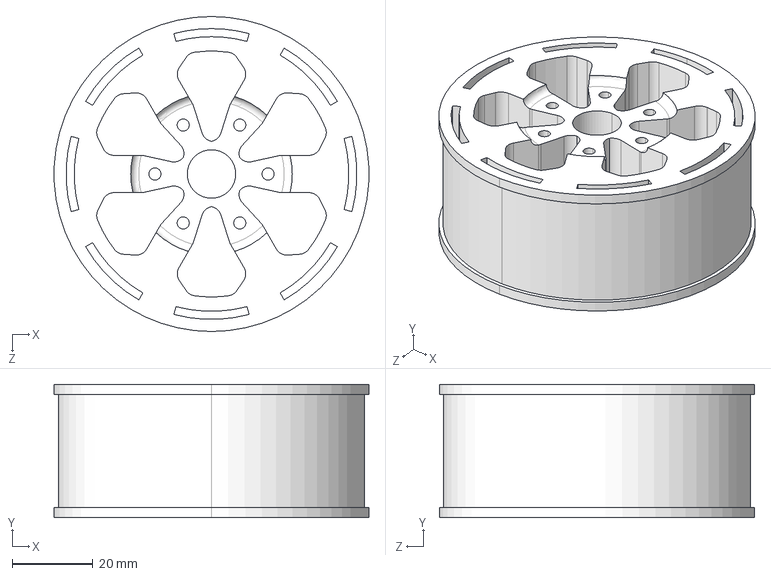
[picture p38: CAD file, 2026-03-29]
finished/机械/3d打印/轮毂.STEP
77.9 x 33.0 x 78.0 mm
