Mr-A-urora/mini_wheel_legged_four/finished/机械/铨州/l1.STEP

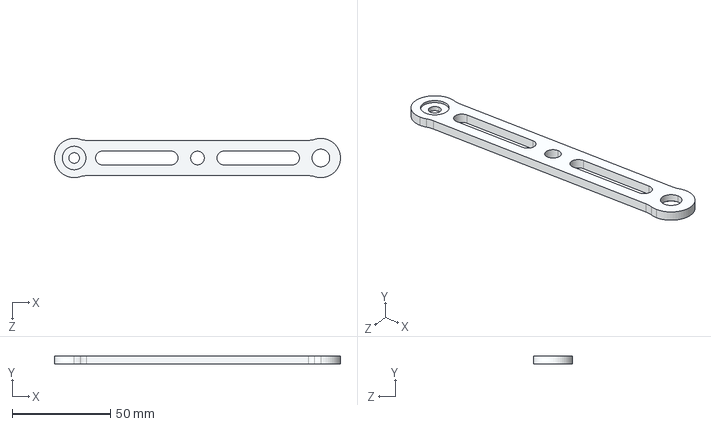
[picture p39: CAD file, 2026-03-29]
finished/机械/铨州/l1.STEP
145.7 x 4.00 x 20.0 mm
