Mr-A-urora/mini_wheel_legged_four/finished/MeArm机械臂图纸，内含part、step、stp、stl/MeArm机械臂PART/后力臂.SLDPRT

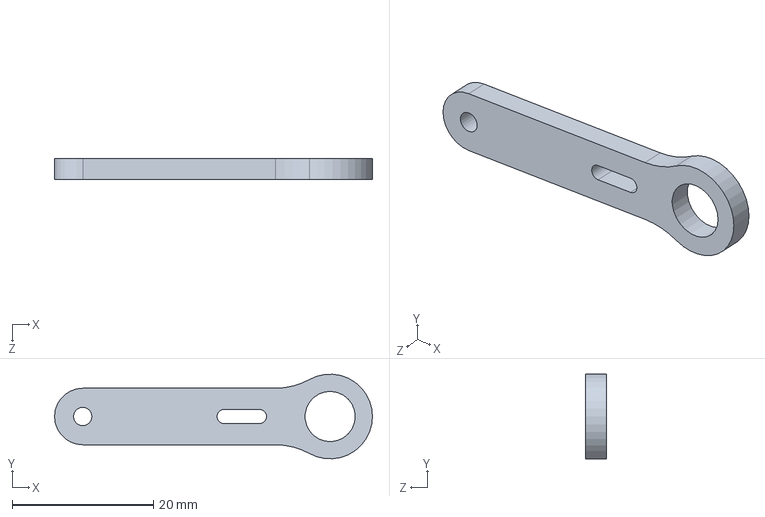
[picture p40: CAD file, 2026-03-29]
finished/MeArm机械臂图纸，内含part、step、stp、stl/MeArm机械臂PART/后力臂.SLDPRT
45.0 x 12.0 x 3.00 mm
