Mr-A-urora/mini_wheel_legged_four/finished/MeArm机械臂图纸，内含part、step、stp、stl/MeArm机械臂STL（新版）/大臂安装座.STL

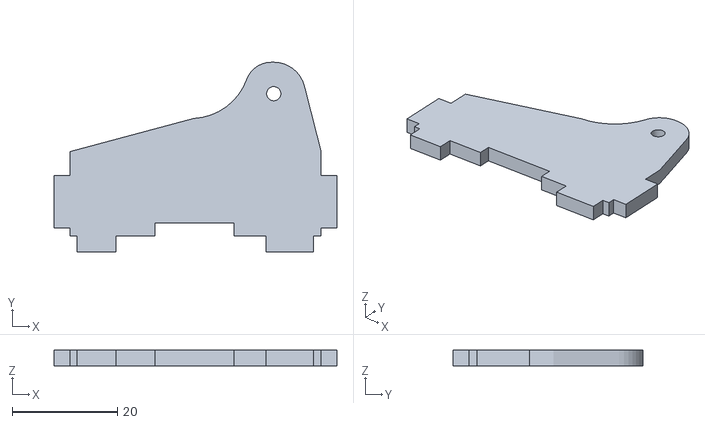
[picture p41: CAD file, 2026-03-29]
finished/MeArm机械臂图纸，内含part、step、stp、stl/MeArm机械臂STL（新版）/大臂安装座.STL
53.7 x 36.0 x 3.00
