Mr-A-urora/mini_wheel_legged_four/finished/机械/3d打印/把手.STEP

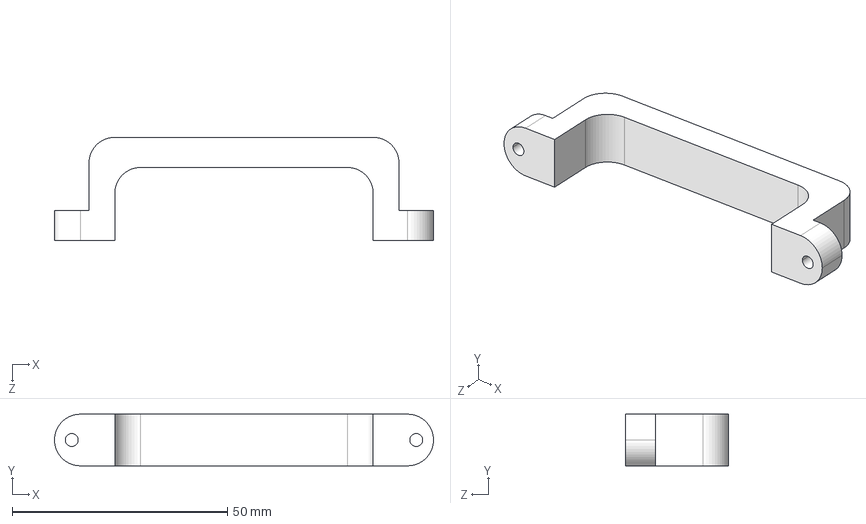
[picture p42: CAD file, 2026-03-29]
finished/机械/3d打印/把手.STEP
88.0 x 12.0 x 24.0 mm
