Mr-A-urora/mini_wheel_legged_four/finished/机械/铨州/head.STEP

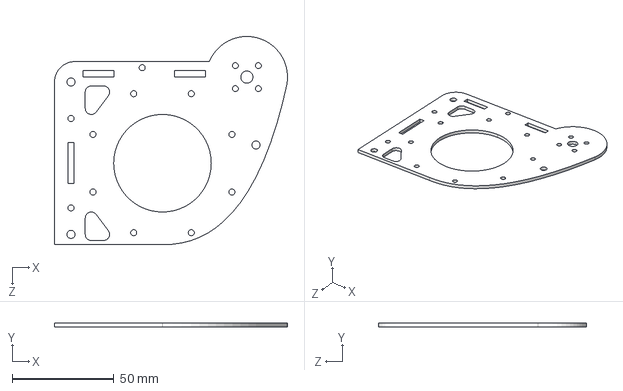
[picture p43: CAD file, 2026-03-29]
finished/机械/铨州/head.STEP
114.6 x 2.00 x 102.4 mm
