Mr-A-urora/mini_wheel_legged_four/finished/机械/3d打印/关节限位.STEP

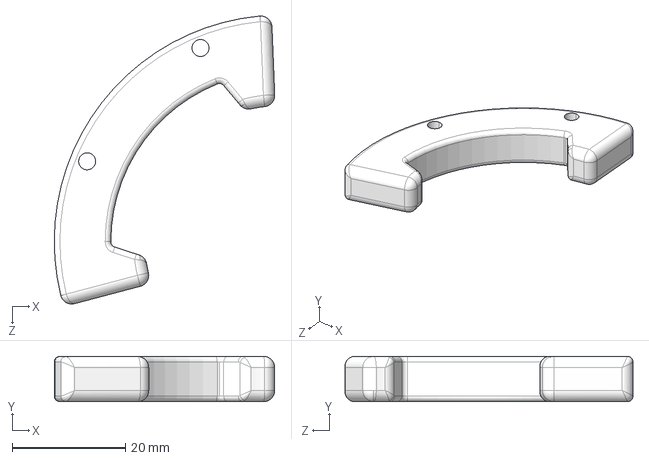
[picture p44: CAD file, 2026-03-29]
finished/机械/3d打印/关节限位.STEP
39.0 x 8.00 x 50.9 mm
