Mr-A-urora/mini_wheel_legged_four/finished/MeArm机械臂图纸，内含part、step、stp、stl/MeArm机械臂STL（新版）/电机安装板.STL

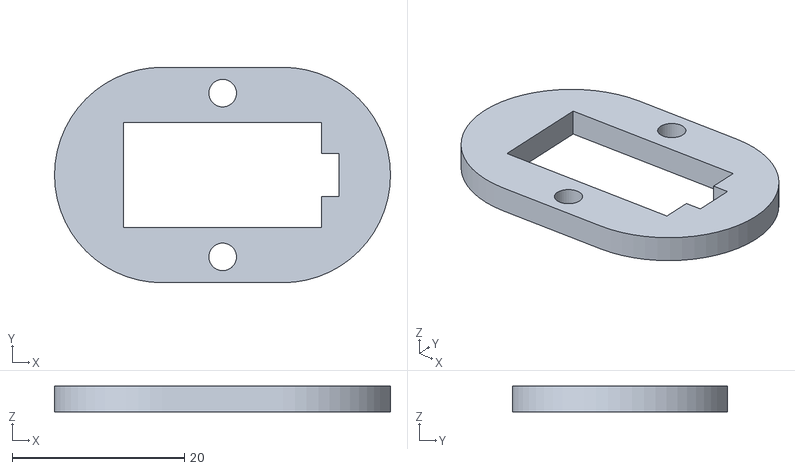
[picture p46: CAD file, 2026-03-29]
finished/MeArm机械臂图纸，内含part、step、stp、stl/MeArm机械臂STL（新版）/电机安装板.STL
39.0 x 25.0 x 3.00
