Mr-A-urora/mini_wheel_legged_four/finished/MeArm机械臂图纸，内含part、step、stp、stl/MeArm机械臂STL（新版）/钳子2.STL

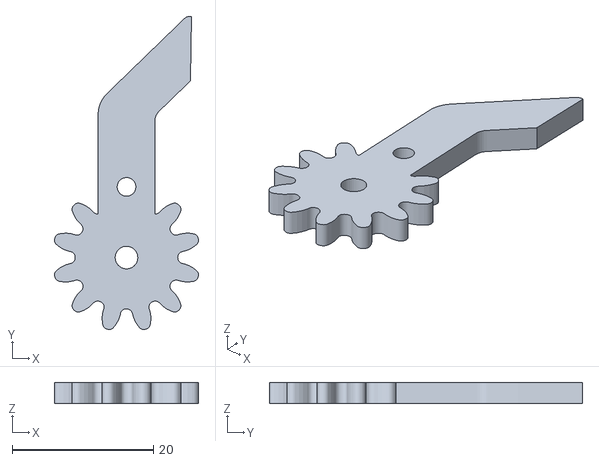
[picture p47: CAD file, 2026-03-29]
finished/MeArm机械臂图纸，内含part、step、stp、stl/MeArm机械臂STL（新版）/钳子2.STL
20.4 x 44.3 x 3.00
