Mr-A-urora/mini_wheel_legged_four/finished/机械/3d打印/树脂-肩膀垫.STEP

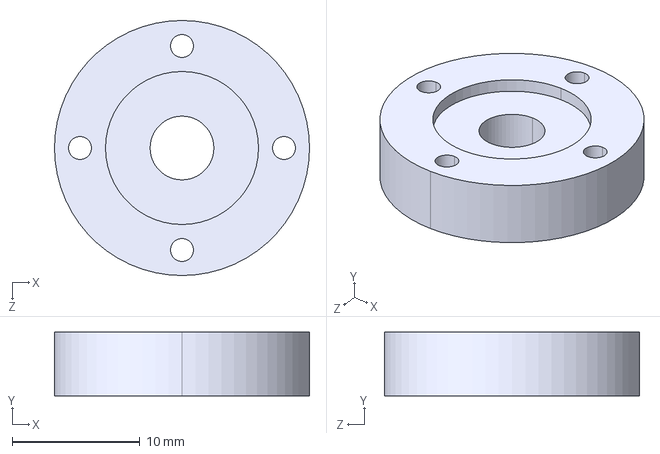
[picture p48: CAD file, 2026-03-29]
finished/机械/3d打印/树脂-肩膀垫.STEP
20.0 x 5.00 x 20.0 mm
