Mr-A-urora/mini_wheel_legged_four/finished/MeArm机械臂图纸，内含part、step、stp、stl/MeArm机械臂PART/钳子舵机安装板.SLDPRT

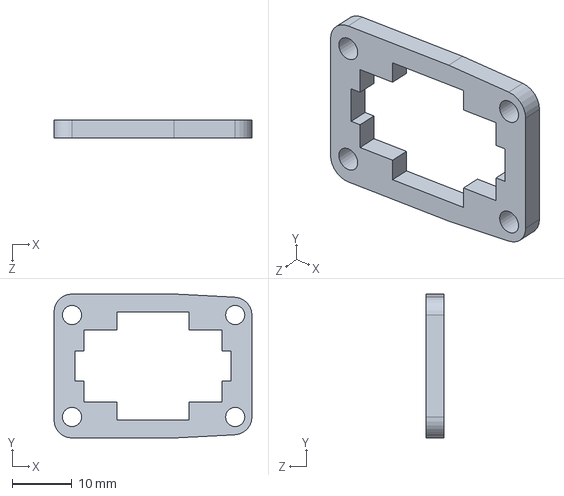
[picture p51: CAD file, 2026-03-29]
finished/MeArm机械臂图纸，内含part、step、stp、stl/MeArm机械臂PART/钳子舵机安装板.SLDPRT
33.0 x 24.0 x 3.00 mm
