Mr-A-urora/mini_wheel_legged_four/finished/机械/BAT.SLDPRT

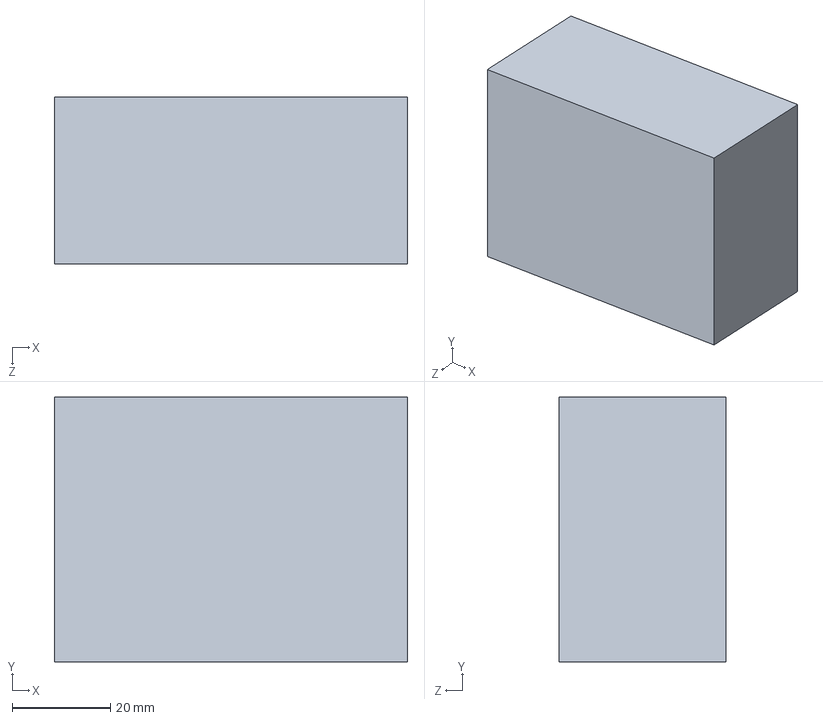
[picture p54: CAD file, 2026-03-29]
finished/机械/BAT.SLDPRT
72.0 x 54.0 x 34.0 mm
