Mr-A-urora/mini_wheel_legged_four/finished/机械/M3单头螺柱.SLDPRT

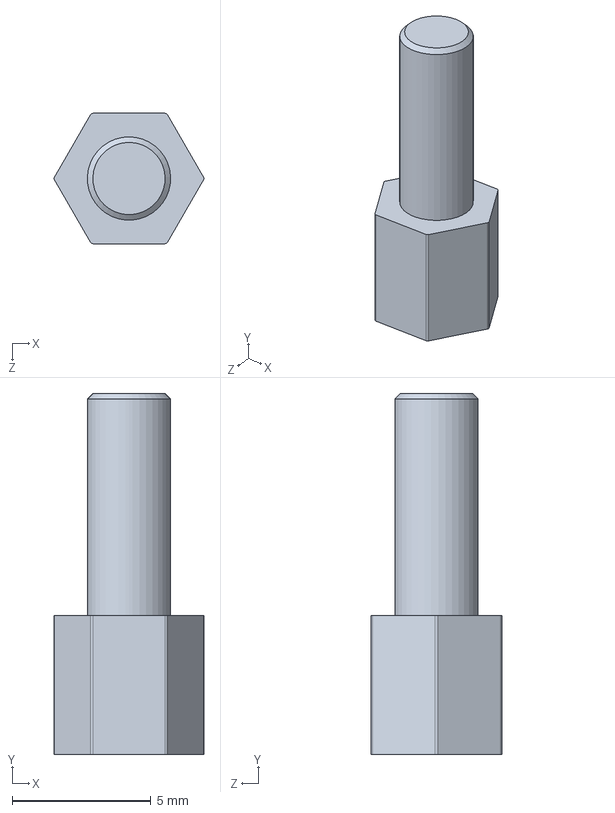
[picture p58: CAD file, 2026-03-29]
finished/机械/M3单头螺柱.SLDPRT
5.40 x 13.0 x 4.70 mm
