Mr-A-urora/mini_wheel_legged_four/finished/机械/夹板螺母对锁螺丝M4.SLDPRT

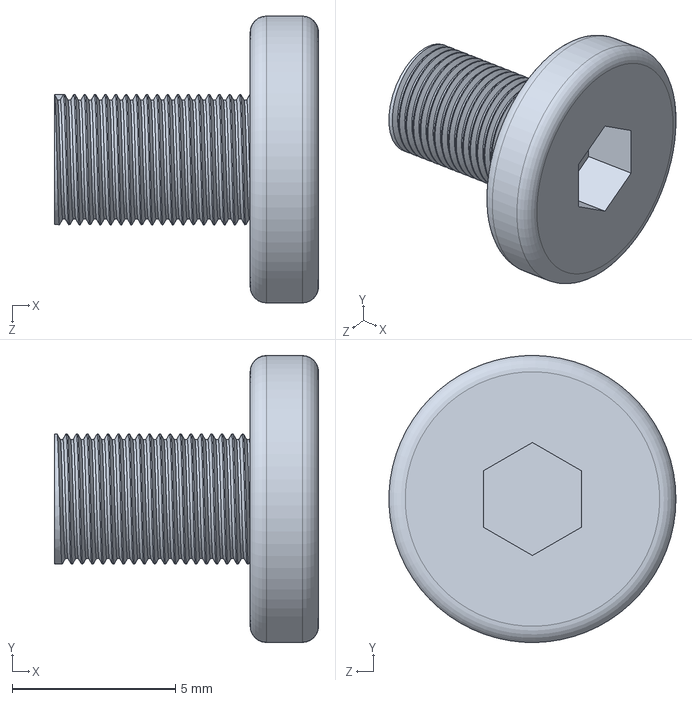
[picture p59: CAD file, 2026-03-29]
finished/机械/夹板螺母对锁螺丝M4.SLDPRT
8.10 x 8.80 x 8.80 mm
