Mr-A-urora/mini_wheel_legged_four/finished/MeArm机械臂图纸，内含part、step、stp、stl/MeArm机械臂PART/前臂角动件.SLDPRT

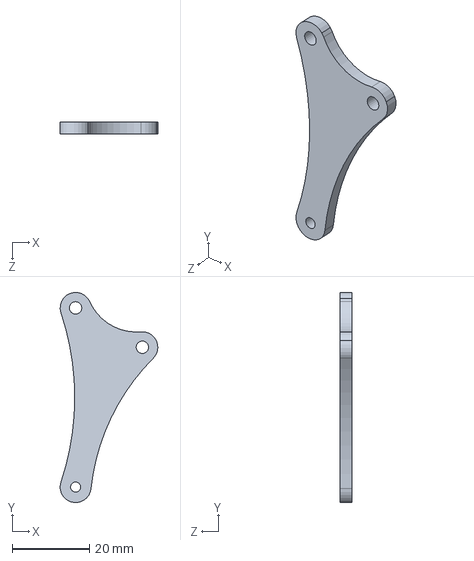
[picture p61: CAD file, 2026-03-29]
finished/MeArm机械臂图纸，内含part、step、stp、stl/MeArm机械臂PART/前臂角动件.SLDPRT
25.2 x 54.2 x 3.00 mm
