Mr-A-urora/mini_wheel_legged_four/finished/机械/microservoSG90.SLDPRT

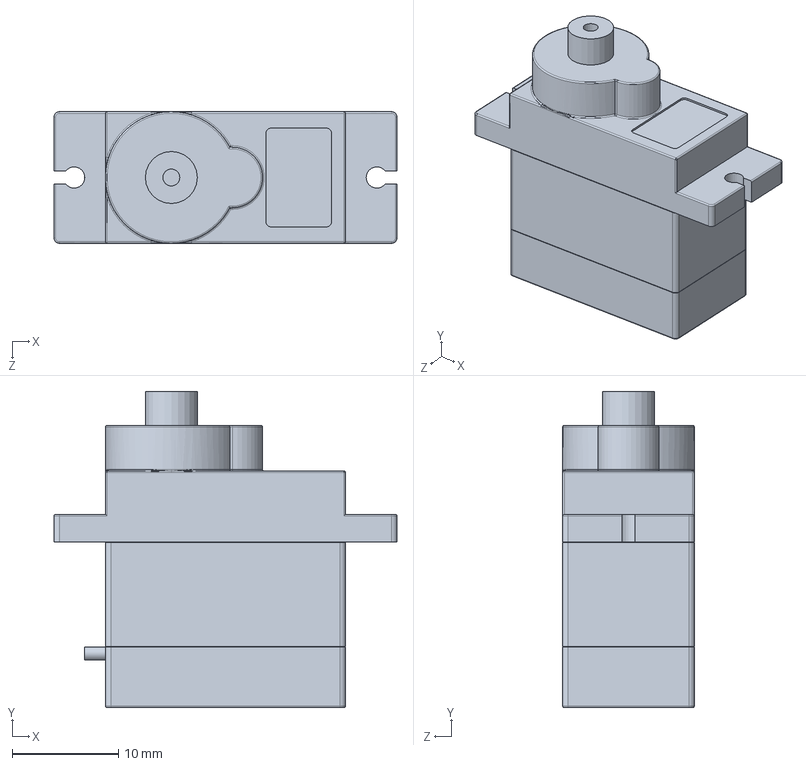
[picture p62: CAD file, 2026-03-29]
finished/机械/microservoSG90.SLDPRT
32.3 x 29.8 x 12.4 mm
