Mr-A-urora/mini_wheel_legged_four/finished/机械/上板.DXF

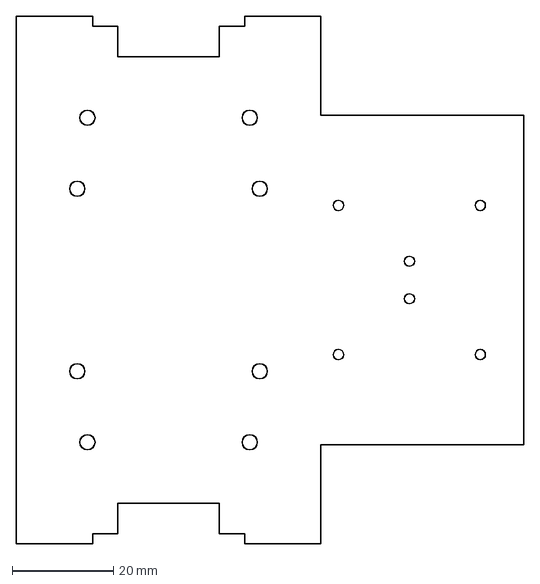
[picture p64: CAD file, 2026-03-29]
finished/机械/上板.DXF
100.0 x 104.0 mm
