Mr-A-urora/mini_wheel_legged_four/finished/机械/夹板螺母对锁M4-12.SLDPRT

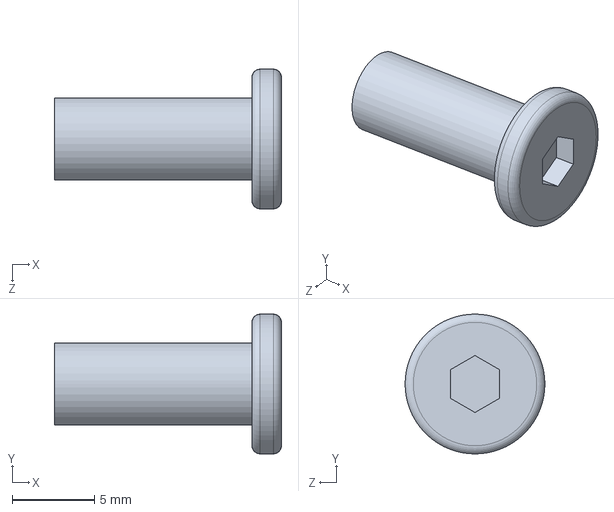
[picture p65: CAD file, 2026-03-29]
finished/机械/夹板螺母对锁M4-12.SLDPRT
13.8 x 8.50 x 8.50 mm
