Mr-A-urora/mini_wheel_legged_four/finished/机械/亚克力上板.SLDPRT

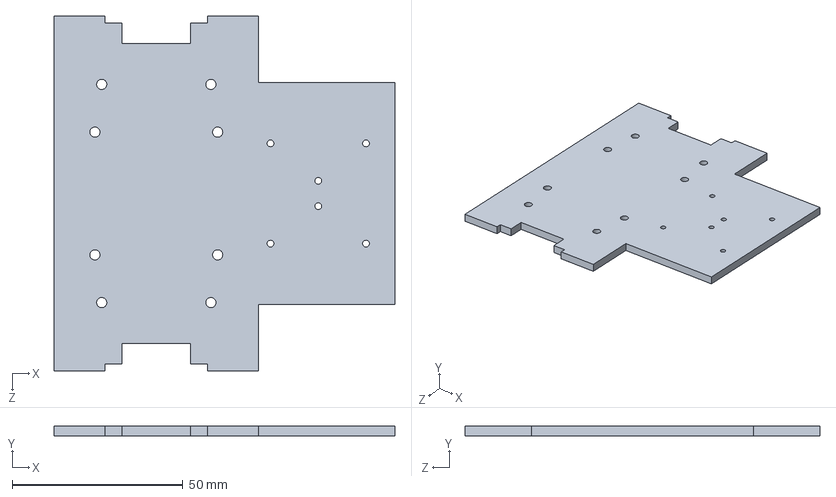
[picture p67: CAD file, 2026-03-29]
finished/机械/亚克力上板.SLDPRT
100.0 x 2.95 x 104.0 mm
