Mr-A-urora/mini_wheel_legged_four/finished/机械/gan.SLDPRT

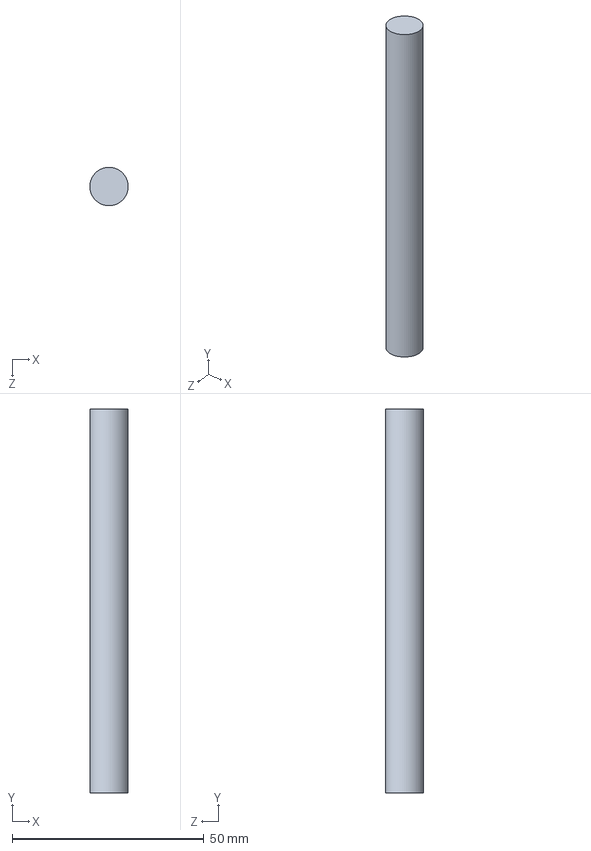
[picture p68: CAD file, 2026-03-29]
finished/机械/gan.SLDPRT
10.00 x 100.0 x 10.0 mm
