Mr-A-urora/mini_wheel_legged_four/finished/机械/法兰.SLDPRT

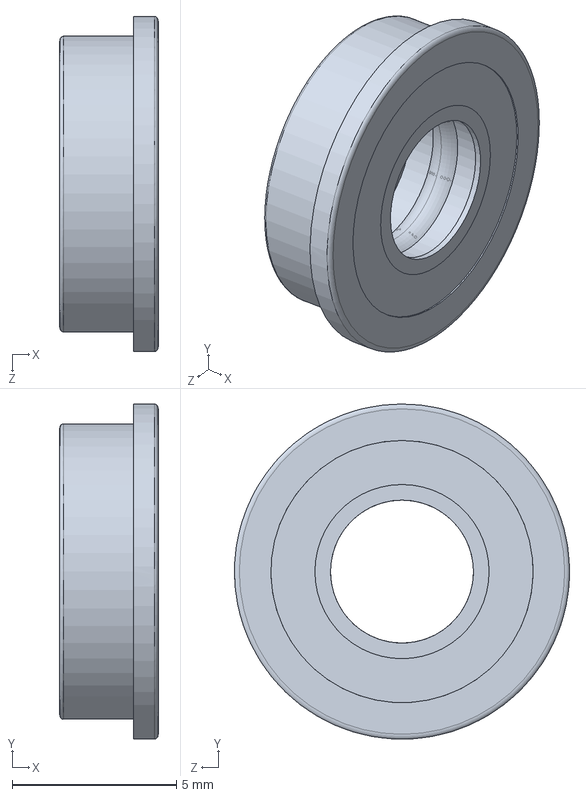
[picture p70: CAD file, 2026-03-29]
finished/机械/法兰.SLDPRT
3.00 x 10.2 x 10.2 mm
