Mr-A-urora/mini_wheel_legged_four/finished/机械/夹板螺母对锁M4-16.SLDPRT

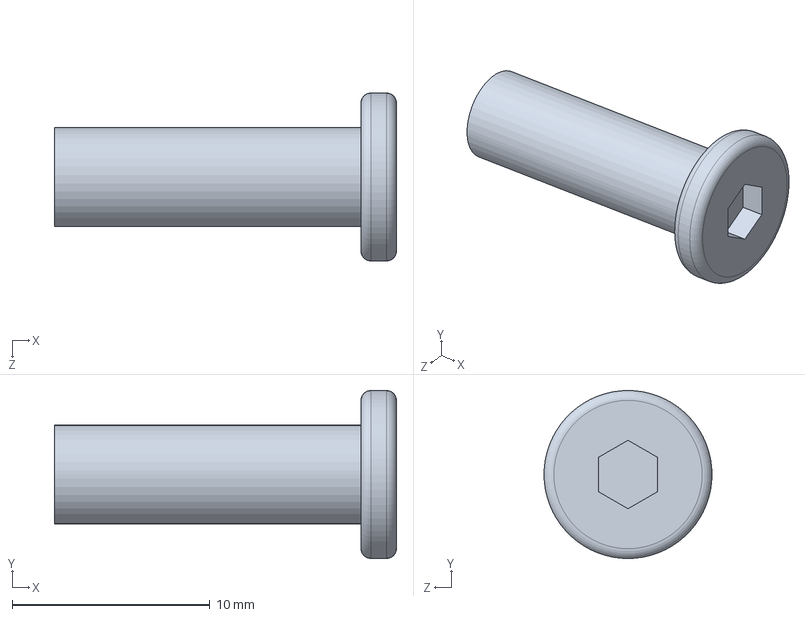
[picture p71: CAD file, 2026-03-29]
finished/机械/夹板螺母对锁M4-16.SLDPRT
17.3 x 8.50 x 8.50 mm
