Mr-A-urora/mini_wheel_legged_four/finished/机械/l3.SLDPRT

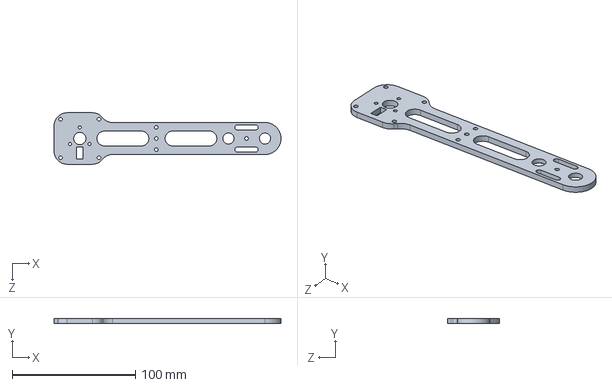
[picture p72: CAD file, 2026-03-29]
finished/机械/l3.SLDPRT
183.8 x 4.00 x 41.8 mm
