Mr-A-urora/mini_wheel_legged_four/(list of files, cad)

Other CAD files:
finished/机械/轮胎.step.SLDASM
finished/机械/Mini-ARX3.SLDASM
finished/MeArm机械臂图纸，内含part、step、stp、stl/MeArm机械臂DWG/MeArm切割图纸.dwg
finished/MeArm机械臂图纸，内含part、step、stp、stl/MeArm机械臂STL（新版）/大臂主.STL
finished/MeArm机械臂图纸，内含part、step、stp、stl/MeArm机械臂STP(装配)/装配体111.STEP
finished/MeArm机械臂图纸，内含part、step、stp、stl/MeArm机械臂PART/小臂1.SLDPRT
finished/MeArm机械臂图纸，内含part、step、stp、stl/MeArm机械臂STL（新版）/小臂2.STL
finished/机械/3d打印/电池仓.STEP
finished/机械/控制板.step
finished/机械/轮毂.SLDPRT
finished/MeArm机械臂图纸，内含part、step、stp、stl/MeArm机械臂STL（新版）/小臂3.STL
finished/机械/舵机力臂.SLDPRT
finished/MeArm机械臂图纸，内含part、step、stp、stl/MeArm机械臂PART/大臂主.SLDPRT
finished/MeArm机械臂图纸，内含part、step、stp、stl/MeArm机械臂STL（新版）/大臂副.STL
finished/机械/l2.SLDPRT
finished/机械/把手.SLDPRT
finished/MeArm机械臂图纸，内含part、step、stp、stl/MeArm机械臂PART/电机安装板 - 副本 (2).SLDPRT
finished/MeArm机械臂图纸，内含part、step、stp、stl/MeArm机械臂STL（新版）/钳子舵机安装板.STL
finished/MeArm机械臂图纸，内含part、step、stp、stl/MeArm机械臂STL（新版）/钳子1.STL
finished/MeArm机械臂图纸，内含part、step、stp、stl/MeArm机械臂PART/垫片1 - 副本 (2).SLDPRT
finished/MeArm机械臂图纸，内含part、step、stp、stl/MeArm机械臂STL（新版）/钳子力臂.STL
finished/MeArm机械臂图纸，内含part、step、stp、stl/MeArm机械臂PART/转台挡板2.SLDPRT
finished/MeArm机械臂图纸，内含part、step、stp、stl/MeArm机械臂PART/转台侧壁1.SLDPRT
finished/MeArm机械臂图纸，内含part、step、stp、stl/MeArm机械臂STL（新版）/钳子舵机安装座.STL
finished/机械/关节限位.SLDPRT
finished/MeArm机械臂图纸，内含part、step、stp、stl/MeArm机械臂PART/底座.SLDPRT
finished/MeArm机械臂图纸，内含part、step、stp、stl/MeArm机械臂STL（新版）/后壁.STL
finished/机械/head.SLDPRT
finished/MeArm机械臂图纸，内含part、step、stp、stl/MeArm机械臂STL（新版）/后力臂.STL
finished/MeArm机械臂图纸，内含part、step、stp、stl/MeArm机械臂PART/大臂安装座.SLDPRT
finished/MeArm机械臂图纸，内含part、step、stp、stl/MeArm机械臂STL（新版）/转台底座.STL
finished/MeArm机械臂图纸，内含part、step、stp、stl/MeArm机械臂PART/钳子2.SLDPRT
finished/MeArm机械臂图纸，内含part、step、stp、stl/MeArm机械臂PART/小臂3.SLDPRT
finished/MeArm机械臂图纸，内含part、step、stp、stl/MeArm机械臂PART/底座电机安装座.SLDPRT
finished/MeArm机械臂图纸，内含part、step、stp、stl/MeArm机械臂STL（新版）/前臂.STL
finished/MeArm机械臂图纸，内含part、step、stp、stl/MeArm机械臂STL（新版）/转台侧壁2.STL
finished/机械/树脂-舵机支架.SLDPRT
finished/MeArm机械臂图纸，内含part、step、stp、stl/MeArm机械臂PART/钳子传动件.SLDPRT
finished/MeArm机械臂图纸，内含part、step、stp、stl/MeArm机械臂STL（新版）/钳子角动件.STL
finished/机械/树脂-关节垫.SLDPRT
finished/MeArm机械臂图纸，内含part、step、stp、stl/MeArm机械臂PART/转台挡板1.SLDPRT
finished/MeArm机械臂图纸，内含part、step、stp、stl/MeArm机械臂PART/小臂2.SLDPRT
finished/MeArm机械臂图纸，内含part、step、stp、stl/MeArm机械臂STL（新版）/钳子与前臂连接件.STL
finished/MeArm机械臂图纸，内含part、step、stp、stl/MeArm机械臂STL（新版）/转台挡板2.STL
finished/机械/265-75 R16 WHEEL.STEP.step.SLDPRT
finished/机械/L3-2.SLDPRT
finished/MeArm机械臂图纸，内含part、step、stp、stl/MeArm机械臂STL（新版）/前臂角动件.STL
finished/机械/l1.SLDPRT
finished/MeArm机械臂图纸，内含part、step、stp、stl/MeArm机械臂STL（新版）/大臂支撑.STL
finished/机械/铝合金轮毂驱动支架.SLDPRT
finished/机械/树脂-肩膀垫.SLDPRT
finished/MeArm机械臂图纸，内含part、step、stp、stl/MeArm机械臂DXF/MeArm切割图纸1：2.dwg
finished/MeArm机械臂图纸，内含part、step、stp、stl/MeArm机械臂PART/转台挡板2(1).SLDPRT
finished/MeArm机械臂图纸，内含part、step、stp、stl/MeArm机械臂STL（新版）/垫片1 - 副本 (2).STL
finished/MeArm机械臂图纸，内含part、step、stp、stl/MeArm机械臂STL（新版）/垫片1 - 副本 (3).STL
finished/MeArm机械臂图纸，内含part、step、stp、stl/MeArm机械臂STL（新版）/垫片1 - 副本.STL
finished/MeArm机械臂图纸，内含part、step、stp、stl/MeArm机械臂STL（新版）/电机安装板 - 副本 (2).STL
finished/MeArm机械臂图纸，内含part、step、stp、stl/MeArm机械臂STL（新版）/电机安装板 - 副本.STL
finished/MeArm机械臂图纸，内含part、step、stp、stl/MeArm机械臂STL（旧版）/MeArm-V0_41-002-AP214 - Arm Base Cross Member-0.stp-1.STL
finished/MeArm机械臂图纸，内含part、step、stp、stl/MeArm机械臂STL（旧版）/MeArm-V0_41-002-AP214 - Arm Base Cross Member.stp-1.STL
finished/MeArm机械臂图纸，内含part、step、stp、stl/MeArm机械臂STL（旧版）/MeArm-V0_41-002-AP214 - Base Plate.stp-1.STL
finished/MeArm机械臂图纸，内含part、step、stp、stl/MeArm机械臂STL（旧版）/MeArm-V0_41-002-AP214 - Bottom Plate.stp-1.STL
finished/MeArm机械臂图纸，内含part、step、stp、stl/MeArm机械臂STL（旧版）/MeArm-V0_41-002-AP214 - Clamp Bottom Servo Mount.stp-1.STL
finished/MeArm机械臂图纸，内含part、step、stp、stl/MeArm机械臂STL（旧版）/MeArm-V0_41-002-AP214 - Clamp Top Servo Mount.stp-1.STL
finished/MeArm机械臂图纸，内含part、step、stp、stl/MeArm机械臂STL（旧版）/MeArm-V0_41-002-AP214 - Gripper Actuating Arm.stp-1.STL
finished/MeArm机械臂图纸，内含part、step、stp、stl/MeArm机械臂STL（旧版）/MeArm-V0_41-002-AP214 - Left Arm Base Joint.stp-1.STL
finished/MeArm机械臂图纸，内含part、step、stp、stl/MeArm机械臂STL（旧版）/MeArm-V0_41-002-AP214 - Left Arm Mount Tab.stp-1.STL
finished/MeArm机械臂图纸，内含part、step、stp、stl/MeArm机械臂STL（旧版）/MeArm-V0_41-002-AP214 - Left Arm Servo Plate.stp-1.STL
finished/MeArm机械臂图纸，内含part、step、stp、stl/MeArm机械臂STL（旧版）/MeArm-V0_41-002-AP214 - Left Gripper.stp-1.STL
finished/MeArm机械臂图纸，内含part、step、stp、stl/MeArm机械臂STL（旧版）/MeArm-V0_41-002-AP214 - Left Wrist Attachment.stp-1.STL
finished/MeArm机械臂图纸，内含part、step、stp、stl/MeArm机械臂STL（旧版）/MeArm-V0_41-002-AP214 - Left Wrist Joint.stp-1.STL
finished/MeArm机械臂图纸，内含part、step、stp、stl/MeArm机械臂STL（旧版）/MeArm-V0_41-002-AP214 - Long Servo Arm.stp-1.STL
finished/MeArm机械臂图纸，内含part、step、stp、stl/MeArm机械臂STL（旧版）/MeArm-V0_41-002-AP214 - Main Arm Cross Web.stp-1.STL
finished/MeArm机械臂图纸，内含part、step、stp、stl/MeArm机械臂STL（旧版）/MeArm-V0_41-002-AP214 - Parallel Linkage Connector.stp-1.STL
finished/MeArm机械臂图纸，内含part、step、stp、stl/MeArm机械臂STL（旧版）/MeArm-V0_41-002-AP214 - Parallel Linkage.stp-1.STL
finished/MeArm机械臂图纸，内含part、step、stp、stl/MeArm机械臂STL（旧版）/MeArm-V0_41-002-AP214 - Parallel Linkage.stp-2.STL
finished/MeArm机械臂图纸，内含part、step、stp、stl/MeArm机械臂STL（旧版）/MeArm-V0_41-002-AP214 - Parallel Linkage.stp-3.STL
finished/MeArm机械臂图纸，内含part、step、stp、stl/MeArm机械臂STL（旧版）/MeArm-V0_41-002-AP214 - Pivot Servo Plate.stp-1.STL
finished/MeArm机械臂图纸，内含part、step、stp、stl/MeArm机械臂STL（旧版）/MeArm-V0_41-002-AP214 - Right Arm Base Joint.stp-1.STL
finished/MeArm机械臂图纸，内含part、step、stp、stl/MeArm机械臂STL（旧版）/MeArm-V0_41-002-AP214 - Right Arm Servo Plate.stp-1.STL
finished/MeArm机械臂图纸，内含part、step、stp、stl/MeArm机械臂STL（旧版）/MeArm-V0_41-002-AP214 - Right Gripper.stp-1.STL
finished/MeArm机械臂图纸，内含part、step、stp、stl/MeArm机械臂STL（旧版）/MeArm-V0_41-002-AP214 - Right Wrist Attachment.stp-1.STL
finished/MeArm机械臂图纸，内含part、step、stp、stl/MeArm机械臂STL（旧版）/MeArm-V0_41-002-AP214 - Right Wrist Joint.stp-1.STL
finished/MeArm机械臂图纸，内含part、step、stp、stl/MeArm机械臂STL（旧版）/MeArm-V0_41-002-AP214 - Servo Retainer.stp-1.STL
finished/MeArm机械臂图纸，内含part、step、stp、stl/MeArm机械臂STL（旧版）/MeArm-V0_41-002-AP214 - Servo Retainer.stp-2.STL
finished/MeArm机械臂图纸，内含part、step、stp、stl/MeArm机械臂STL（旧版）/MeArm-V0_41-002-AP214 - Servo Retainer.stp-3.STL
finished/MeArm机械臂图纸，内含part、step、stp、stl/MeArm机械臂STL（旧版）/MeArm-V0_41-002-AP214 - Short Servo Arm.stp-1.STL
finished/MeArm机械臂图纸，内含part、step、stp、stl/MeArm机械臂STL（旧版）/MeArm-V0_41-002-AP214 - Spacer.stp-1.STL
finished/MeArm机械臂图纸，内含part、step、stp、stl/MeArm机械臂STL（旧版）/MeArm-V0_41-002-AP214 - Spacer.stp-2.STL
finished/MeArm机械臂图纸，内含part、step、stp、stl/MeArm机械臂STL（旧版）/MeArm-V0_41-002-AP214 - Spacer.stp-3.STL
finished/MeArm机械臂图纸，内含part、step、stp、stl/MeArm机械臂STL（旧版）/MeArm-V0_41-002-AP214 - Spacer.stp-4.STL
finished/MeArm机械臂图纸，内含part、step、stp、stl/MeArm机械臂STP(装配)/装配体1(1).SLDASM
finished/机械/3d打印/电池仓(1).STEP
finished/机械/3d打印/电池仓.SLDPRT
finished/机械/M4_5_12.SLDPRT
finished/机械/M4_5_16.SLDPRT
finished/机械/M63A_111/M0603A_111_3d.SLDASM
finished/机械/螺丝/M2_8.SLDPRT
finished/机械/螺丝/M3_14.SLDPRT
finished/机械/螺丝/M3_20.SLDPRT
finished/机械/螺丝/M3_6.SLDPRT
finished/机械/螺丝/M3_8.SLDPRT
finished/机械/螺丝/M4_10.SLDPRT
