Mr-A-urora/mini_wheel_legged_four/finished/MeArm机械臂图纸，内含part、step、stp、stl/mearm机械臂组装教程(1).docx

# MEARM机械臂组装教程

### 螺丝清单及用途：

M3*25 4 个 底座4

M3*12 7 个 转台4，大臂2，钳子1

M3*10 5 个 三层厚度处使用

M3*8 10个 舵机安装，钳子舵机4个，其余各2个

M3*6 9个 两层厚度处使用

螺母 10个

1.将M3*25螺栓4跟串入底座，并上螺母，不要预紧

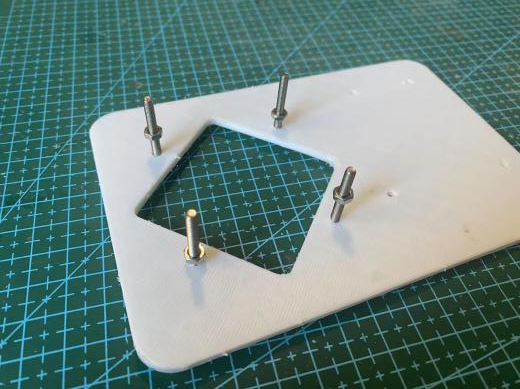
[picture p73: figure]
微信图片_20221218153656

2.将螺栓顶部扭入电机安装座

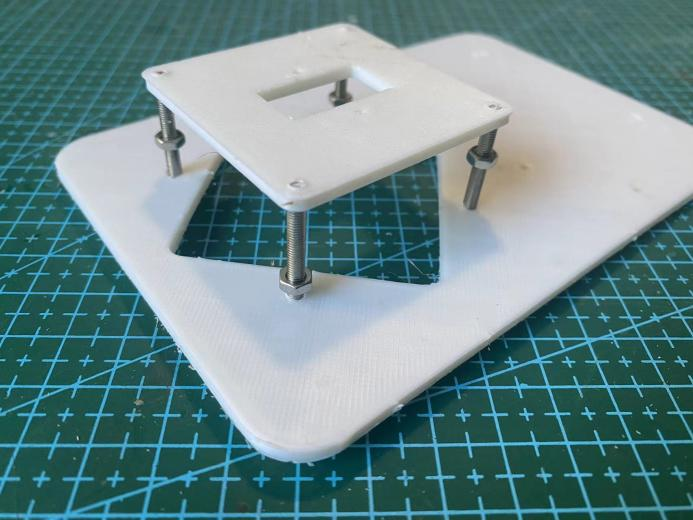
[picture p74: figure]
微信图片_20221218153710

3.预紧螺母

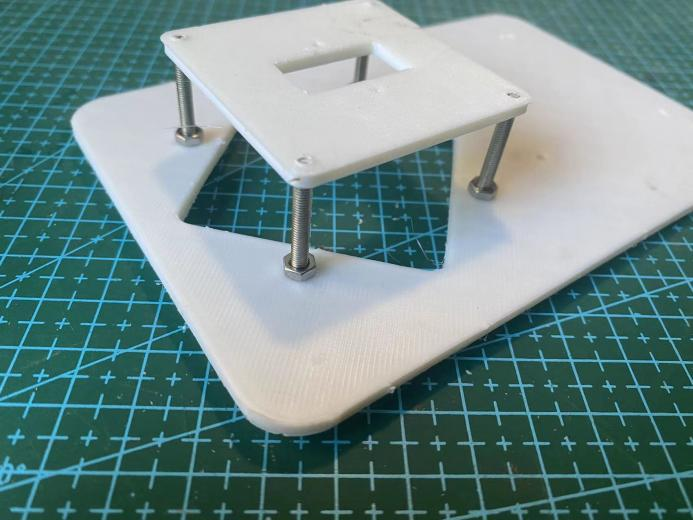
[picture p75: figure]
微信图片_20221218153715

4.安装底座电机使用M3*8螺栓2颗

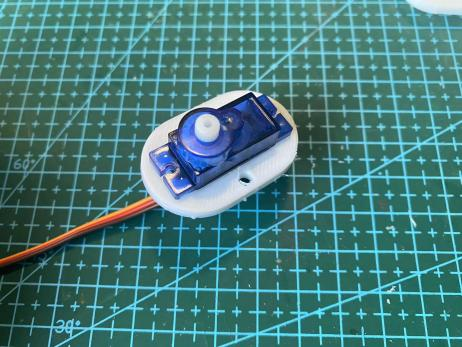
[picture p76: figure]
微信图片_20221218153724
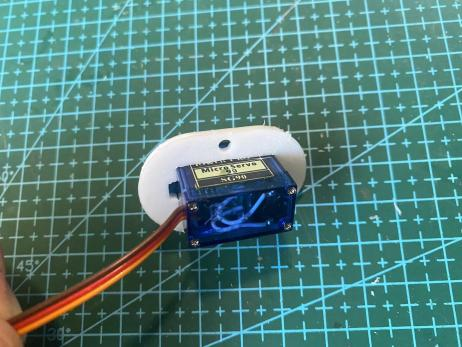
[picture p77: figure]
微信图片_20221218153719
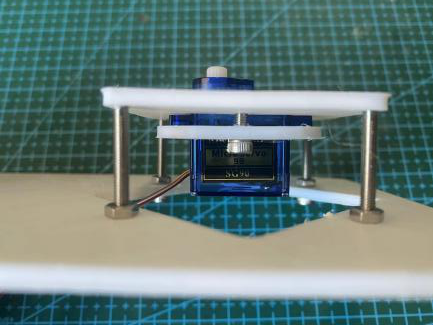
[picture p78: figure]
微信图片_20221218153732
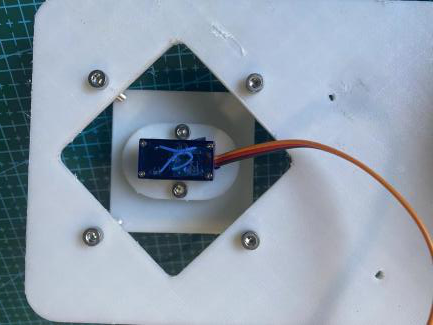
[picture p79: figure]
微信图片_20221218153744
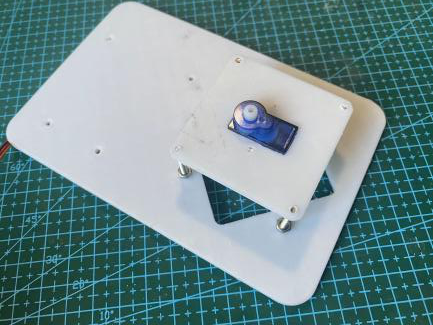
[picture p80: figure]
微信图片_20221218153739

8.转台内测装入舵机摇臂，并加螺丝固定（自攻螺丝为舵机附带产品）

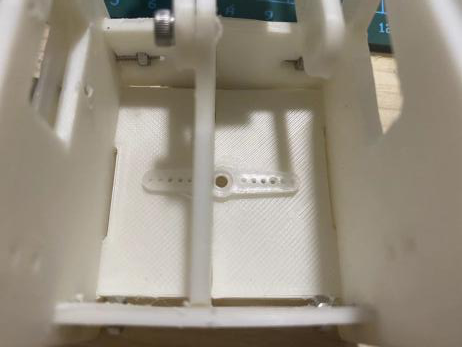
[picture p81: figure]
微信图片_20221218200615

5. 转台安装：注意各个零件孔位及朝向切勿装反（零件为过盈配合，可使用小锤轻轻敲击或者用砂纸打磨装配部位）

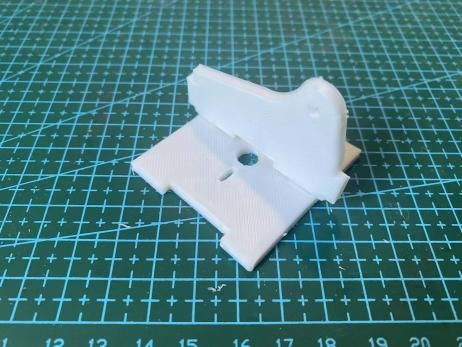
[picture p82: figure]
微信图片_20221218161437
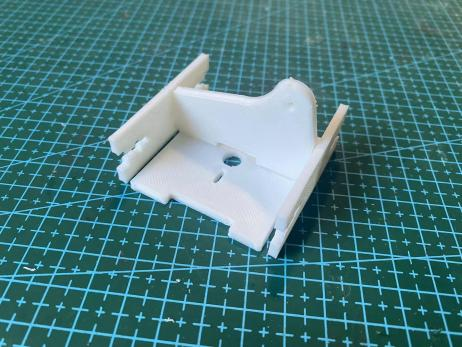
[picture p83: figure]
微信图片_20221218161441
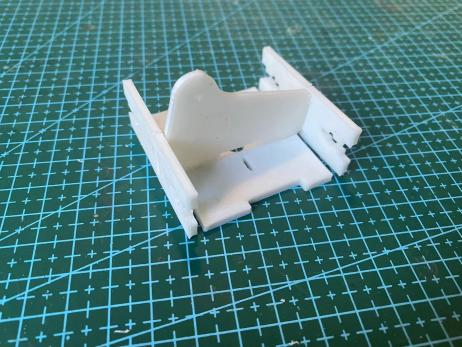
[picture p84: figure]
微信图片_20221218161447
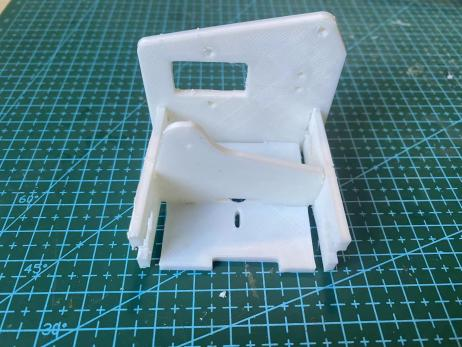
[picture p85: figure]
微信图片_20221218161451
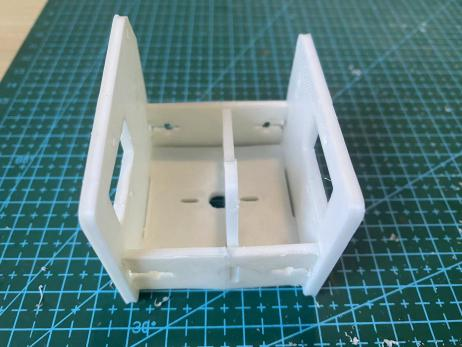
[picture p86: figure]
微信图片_20221218161503
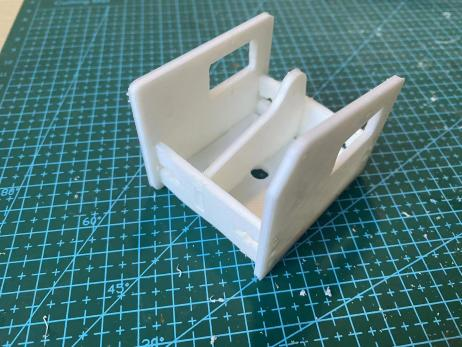
[picture p87: figure]
微信图片_20221218161500

6.嵌入螺母

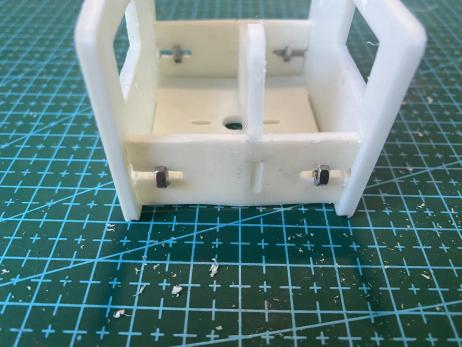
[picture p88: figure]
微信图片_20221218161512

7.螺丝规格为M3*12，如图预紧

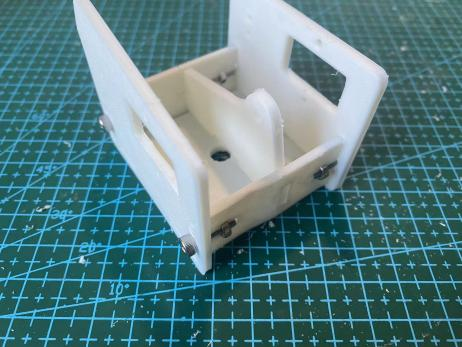
[picture p89: figure]
微信图片_20221218161516
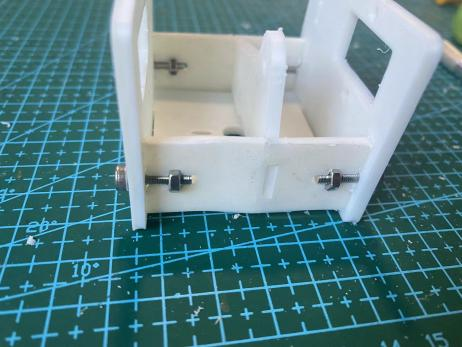
[picture p90: figure]
微信图片_20221218161520

8.转台背面装入舵机带摇臂，并加螺丝固定（自攻螺丝为舵机附带产品）

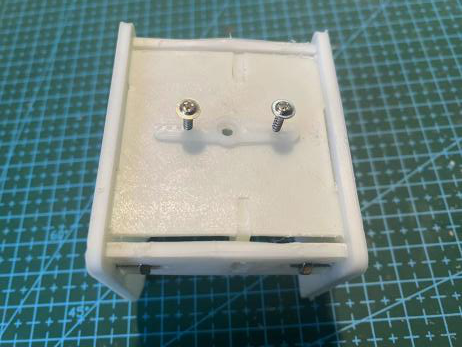
[picture p91: figure]
微信图片_20221218162739

9.后壁组装，两个螺母，两个M3*12螺栓

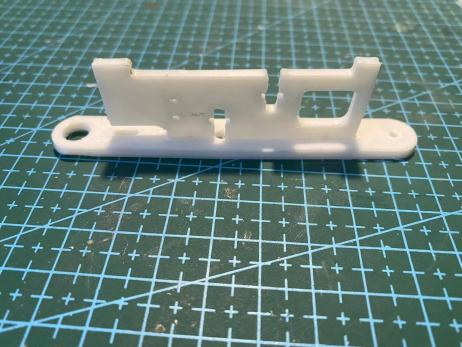
[picture p92: figure]
微信图片_20221218165318
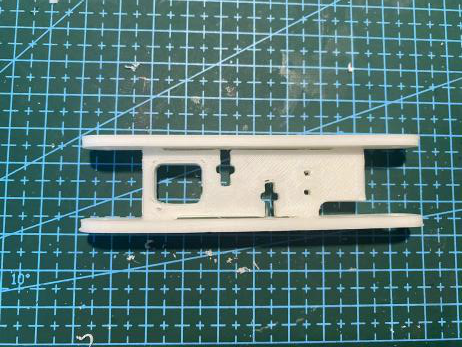
[picture p93: figure]
微信图片_20221218165323
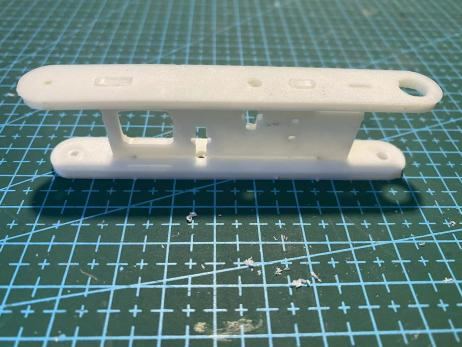
[picture p94: figure]
微信图片_20221218165326
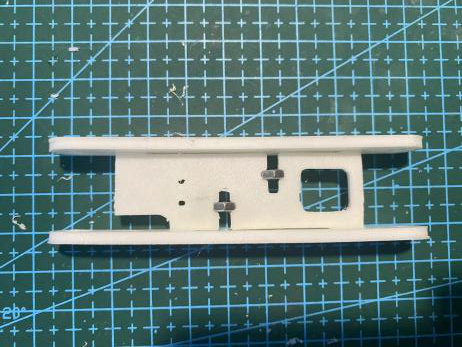
[picture p95: figure]
微信图片_20221218165331
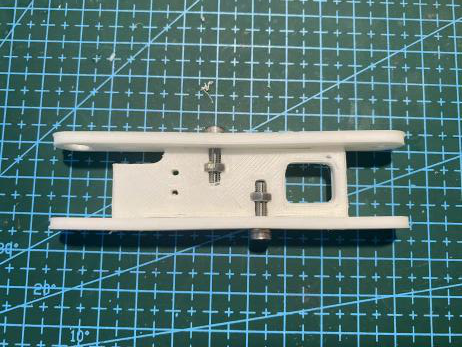
[picture p96: figure]
微信图片_20221218165335

安装舵机摇臂，并加螺丝固定

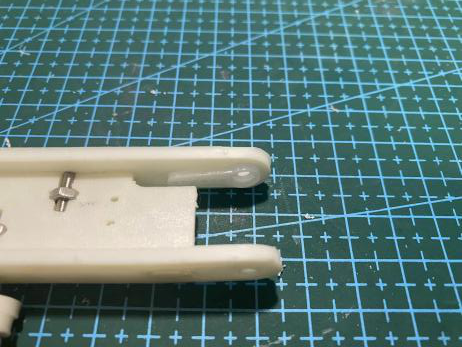
[picture p97: figure]
微信图片_20221218194013

10.使用M3*6螺栓安装此零件（注意安装在后臂无舵机一侧）

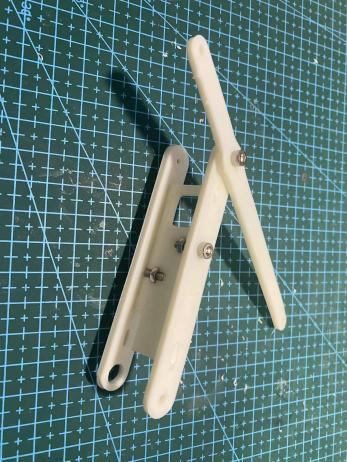
[picture p98: figure]
微信图片_20221218171249

11.选用图中两端皆为大孔的零件使用M3*6螺栓如图安装

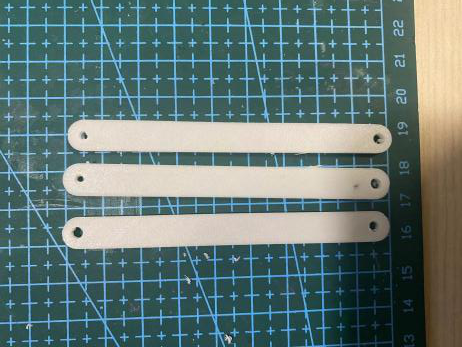
[picture p99: figure]
微信图片_20221218170929

12.使用M3*6螺栓如图安装

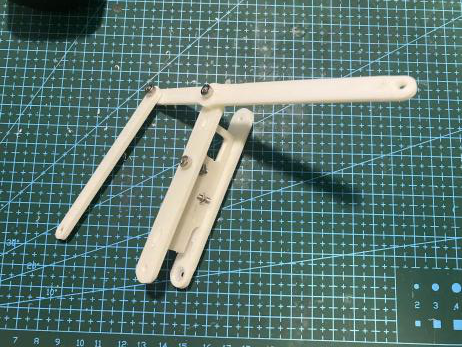
[picture p100: figure]
微信图片_20221218170936

13.准备以下零件

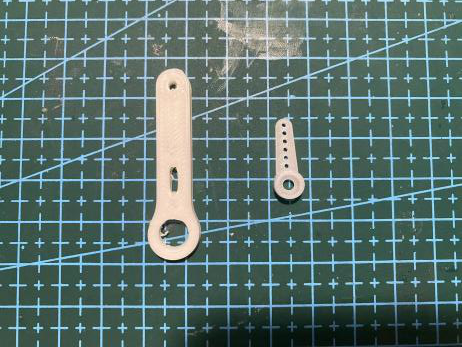
[picture p101: figure]
微信图片_20221218181827

14.使用M3*6螺栓如图，组装到步骤12部件中

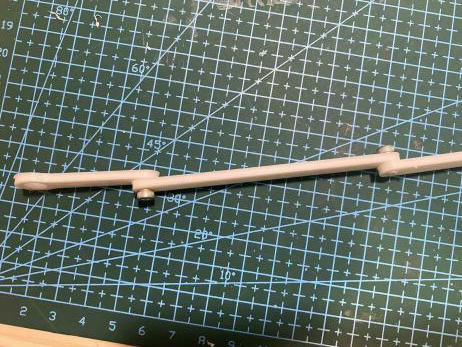
[picture p102: figure]
微信图片_20221218181801
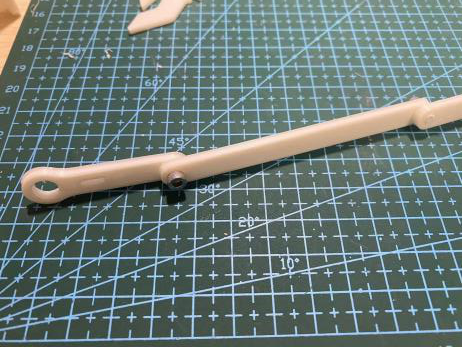
[picture p103: figure]
微信图片_20221218181805

15.安装摇臂

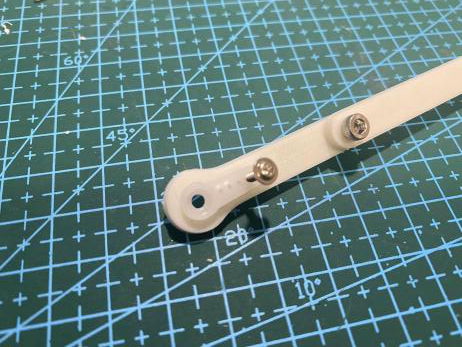
[picture p104: figure]
微信图片_20221218181751
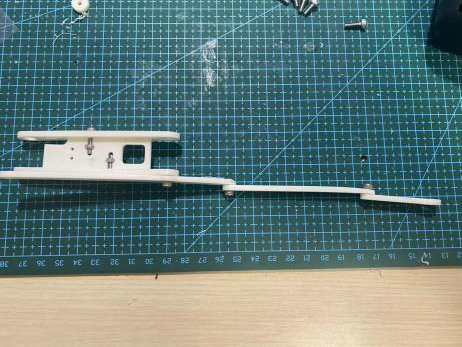
[picture p105: figure]
微信图片_20230103001144

16.准备一下材料

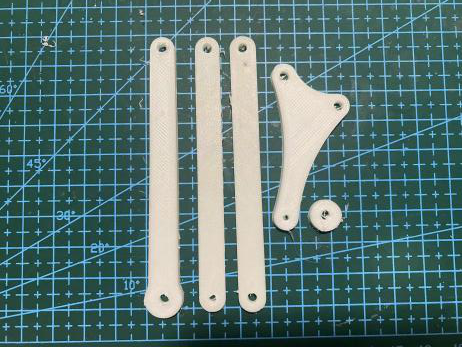
[picture p106: figure]
微信图片_20221218173910

17. 使用M3*10螺栓如图安装

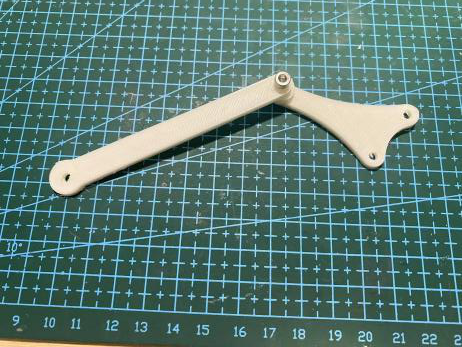
[picture p107: figure]
微信图片_20221218173916
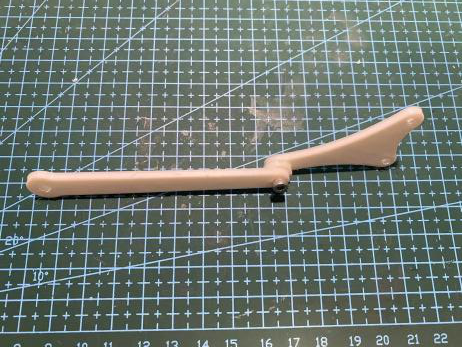
[picture p108: figure]
微信图片_20221218173929
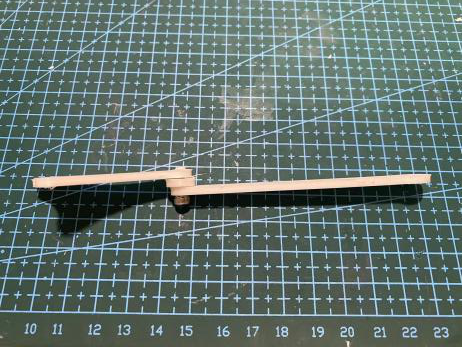
[picture p109: figure]
微信图片_20221218173922

18. 使用M3*10螺栓加垫片如图安装

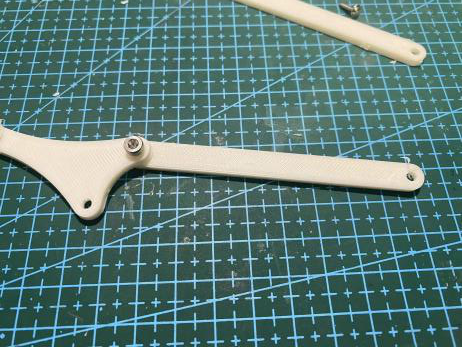
[picture p110: figure]
微信图片_20221218173935
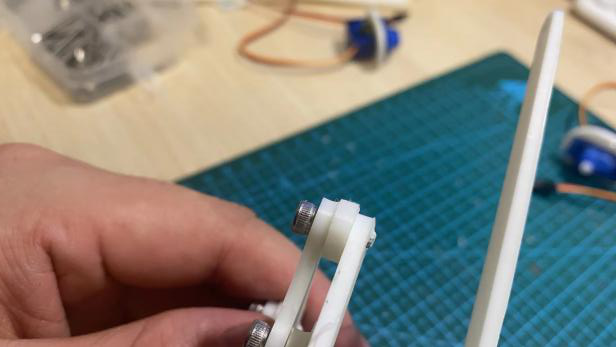
[picture p111: figure]
微信图片_20221218195205

19使用M3*10螺栓将前臂于后臂组装到一起，如图所示

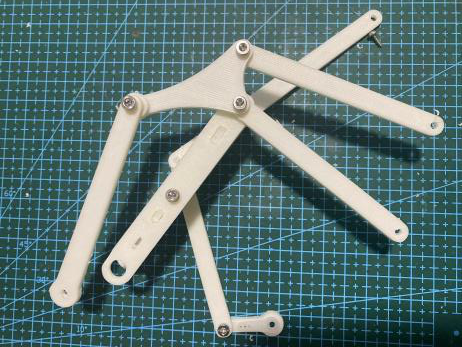
[picture p112: figure]
微信图片_20221218173946
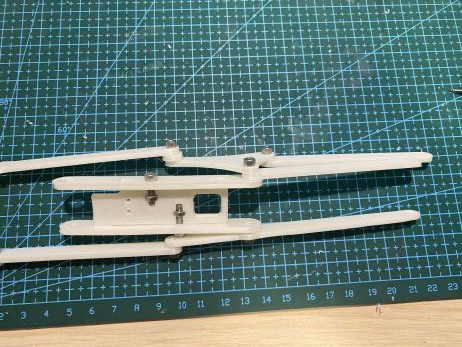
[picture p113: figure]
微信图片_20221218174025

20.准备以下零件

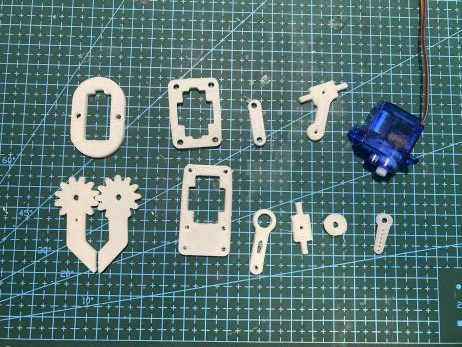
[picture p114: figure]
微信图片_20221218183859

21.按照一下顺序进行组装，零件可适当打磨

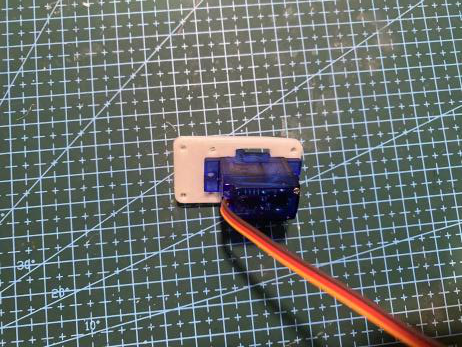
[picture p115: figure]
微信图片_20221218183903
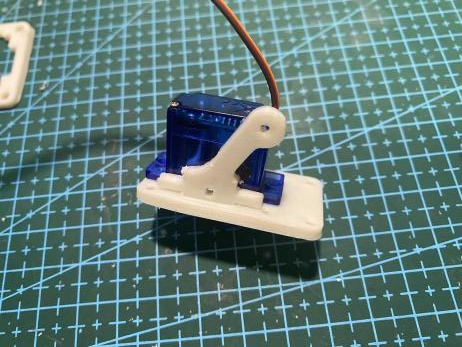
[picture p116: figure]
微信图片_20221218183906
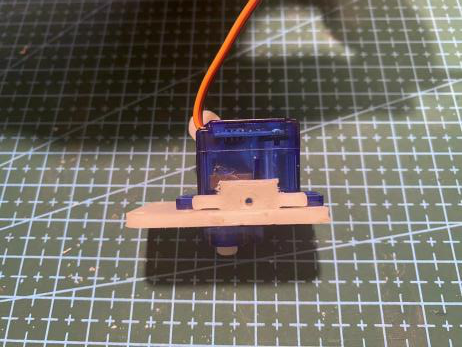
[picture p117: figure]
微信图片_20221218183910
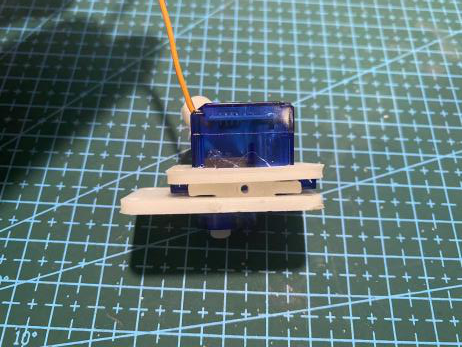
[picture p118: figure]
微信图片_20221218183917
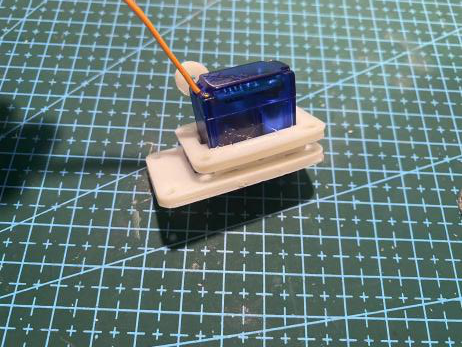
[picture p119: figure]
微信图片_20221218183914
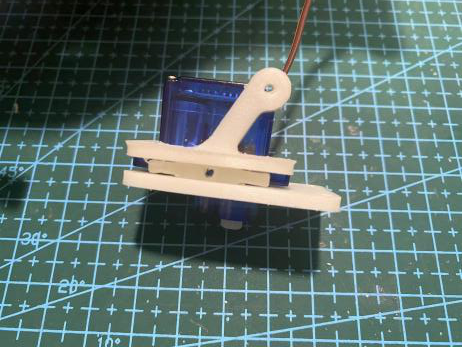
[picture p120: figure]
微信图片_20221218183922

22.使用M3*8螺栓固定

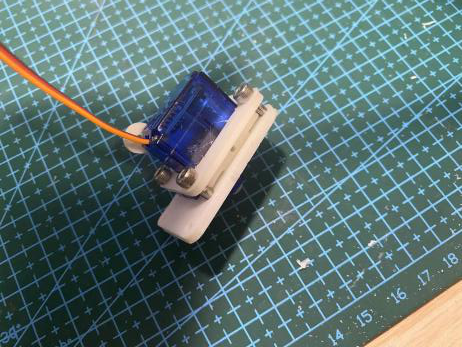
[picture p121: figure]
微信图片_20221218183933

23.使用M3*6螺栓安装钳子

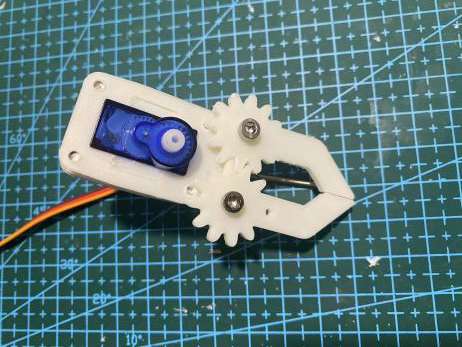
[picture p122: figure]
微信图片_20221218185931

23，使用M3*12螺栓安装钳子前臂，配合两个垫片

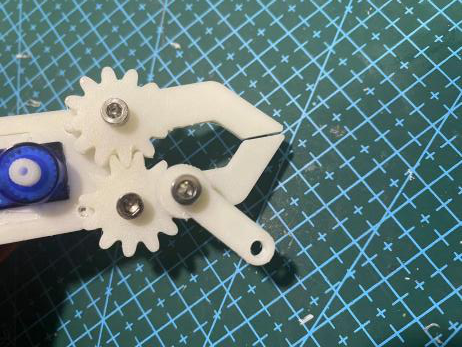
[picture p123: figure]
微信图片_20221218185937
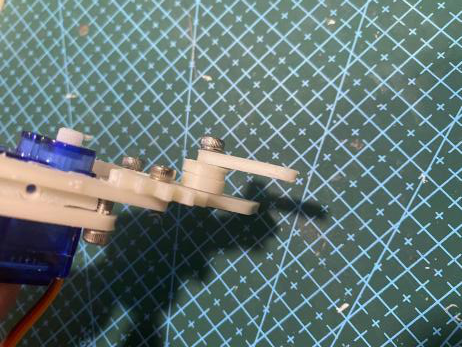
[picture p124: figure]
微信图片_20221218185944

24.使用M3*6螺栓，安装钳子后臂

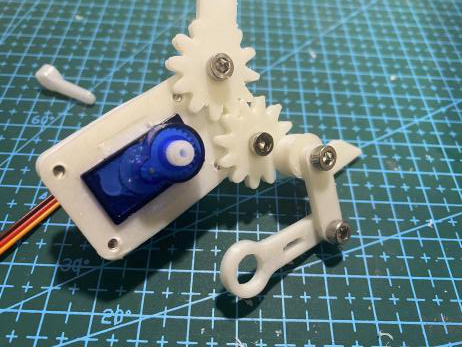
[picture p125: figure]
微信图片_20221218185940

25.安装舵机摇臂后，将后臂安装到舵机上

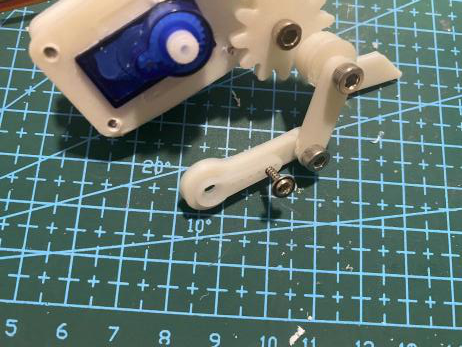
[picture p126: figure]
微信图片_20221218185948
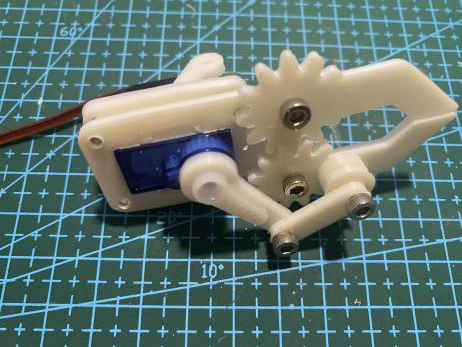
[picture p127: figure]
微信图片_20221218185959

26.使用M3*6螺栓，将主臂与转台链接

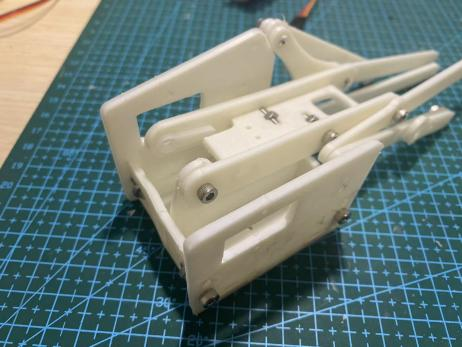
[picture p128: figure]
微信图片_20221218200900

27.使用M3*6螺栓，将后臂与转台链接

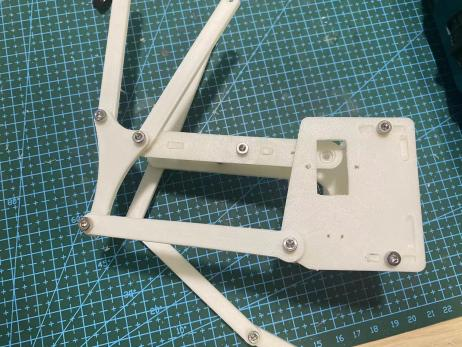
[picture p129: figure]
微信图片_20221218200906

28.使用M3*10螺栓，将前下臂与钳子链接

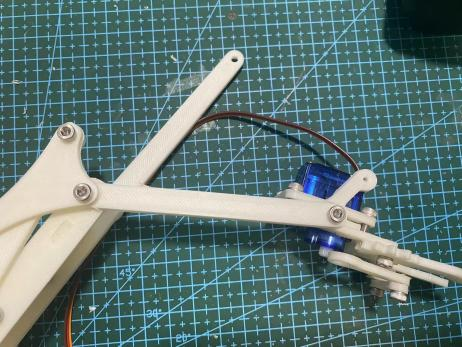
[picture p130: figure]
微信图片_20221218200910

29.使用使用M3*6螺栓，将前上臂与钳子链接

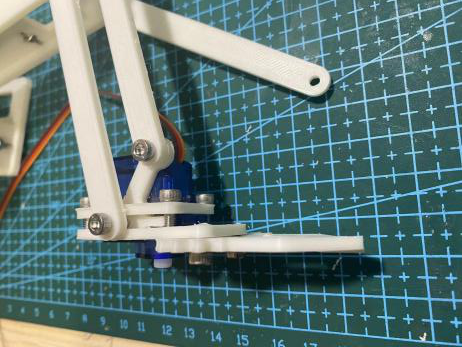
[picture p131: figure]
微信图片_20221218200915

30.使用M3*10螺栓，将左侧前臂与钳子链接

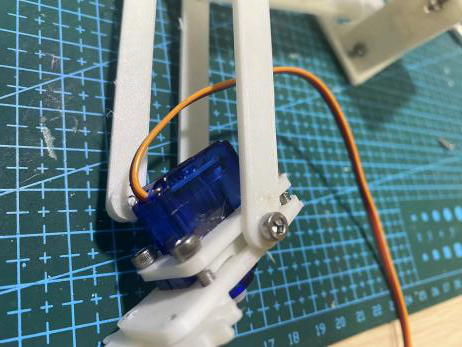
[picture p132: figure]
微信图片_20221218200920

31. 安装前后臂舵机M3*8

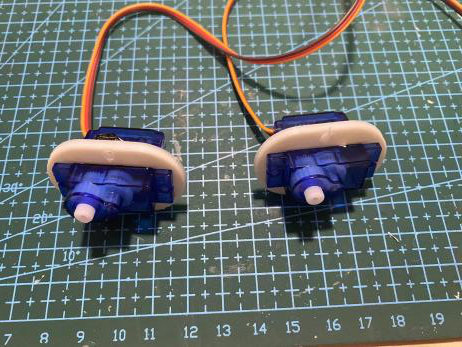
[picture p133: figure]
微信图片_20221218200924
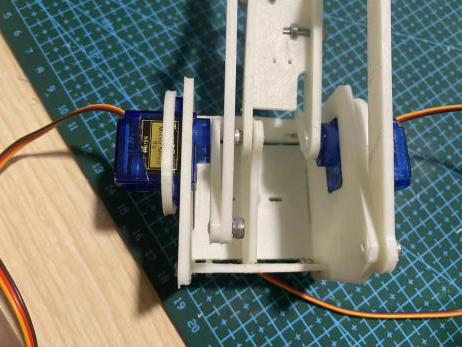
[picture p134: figure]
微信图片_20221218200929
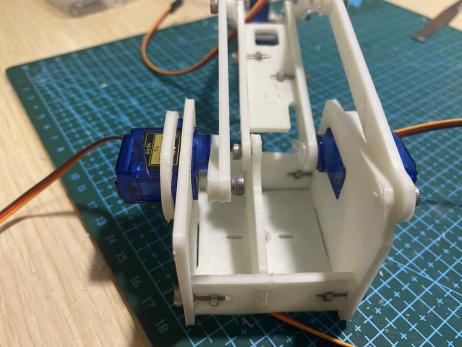
[picture p135: figure]
微信图片_20221218200937
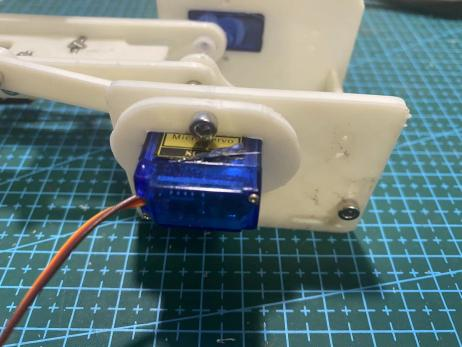
[picture p136: figure]
微信图片_20221218200941

32. 安装砖台

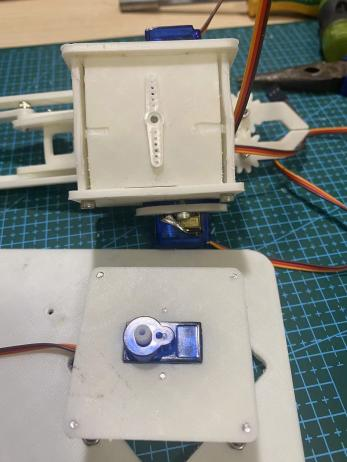
[picture p137: figure]
微信图片_20221218200948

33.组装完成

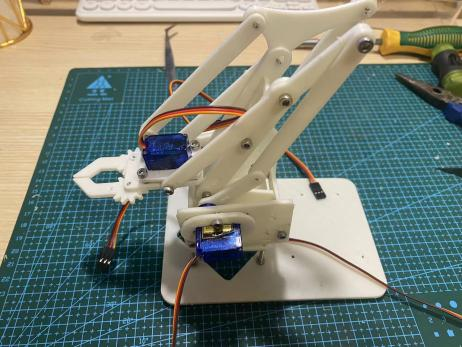
[picture p138: figure]
微信图片_20221218200952
