Mr-A-urora/mini_wheel_legged_four/finished/hardware/主控原理图.pdf

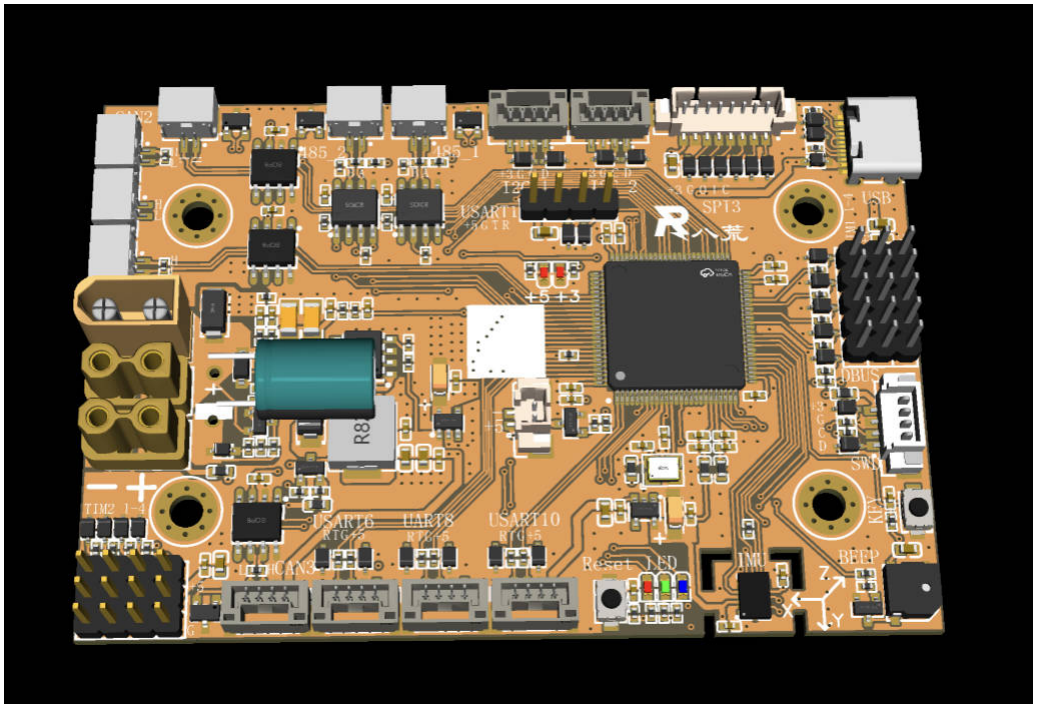
[picture p139: figure]

V1.0 | A3 | 八荒

## 机器人控制

| | 2025-06-15
2025-02-17 Schematic1 | 1

## main

审阅

绘制

版本

### 创建日期 物料编码 页

共

### 原理图

### 更新日期

尺寸

图页

# CAN1

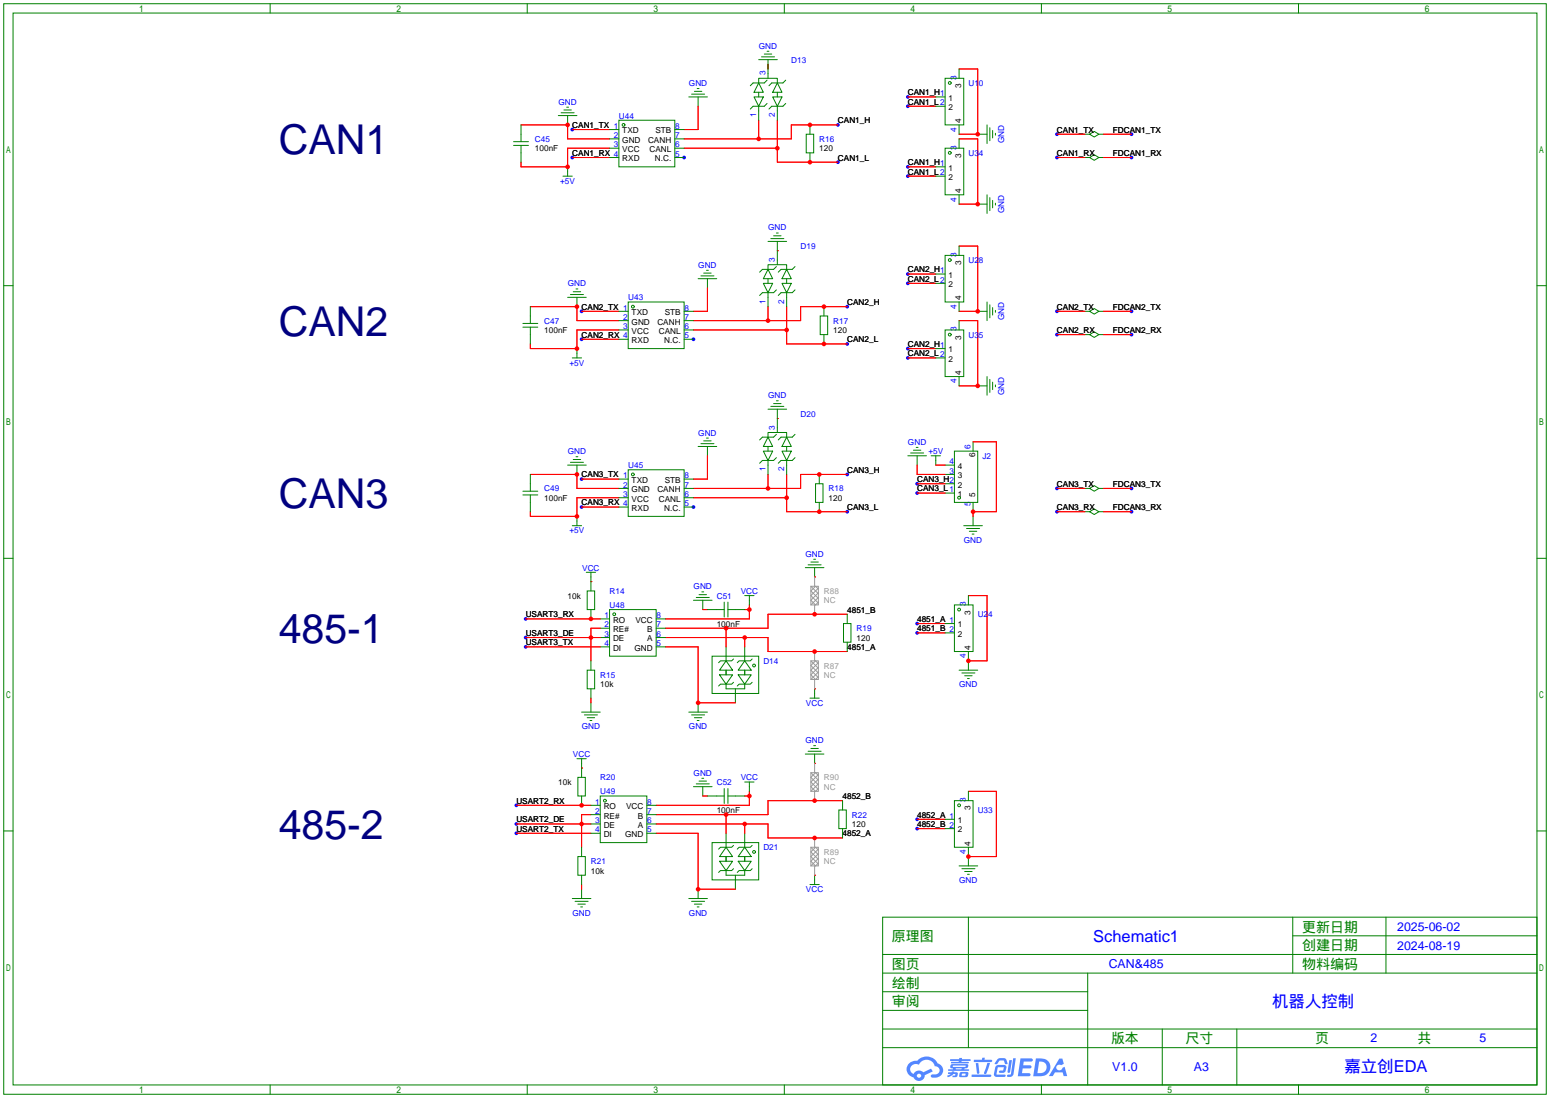
[picture p140: page 2]

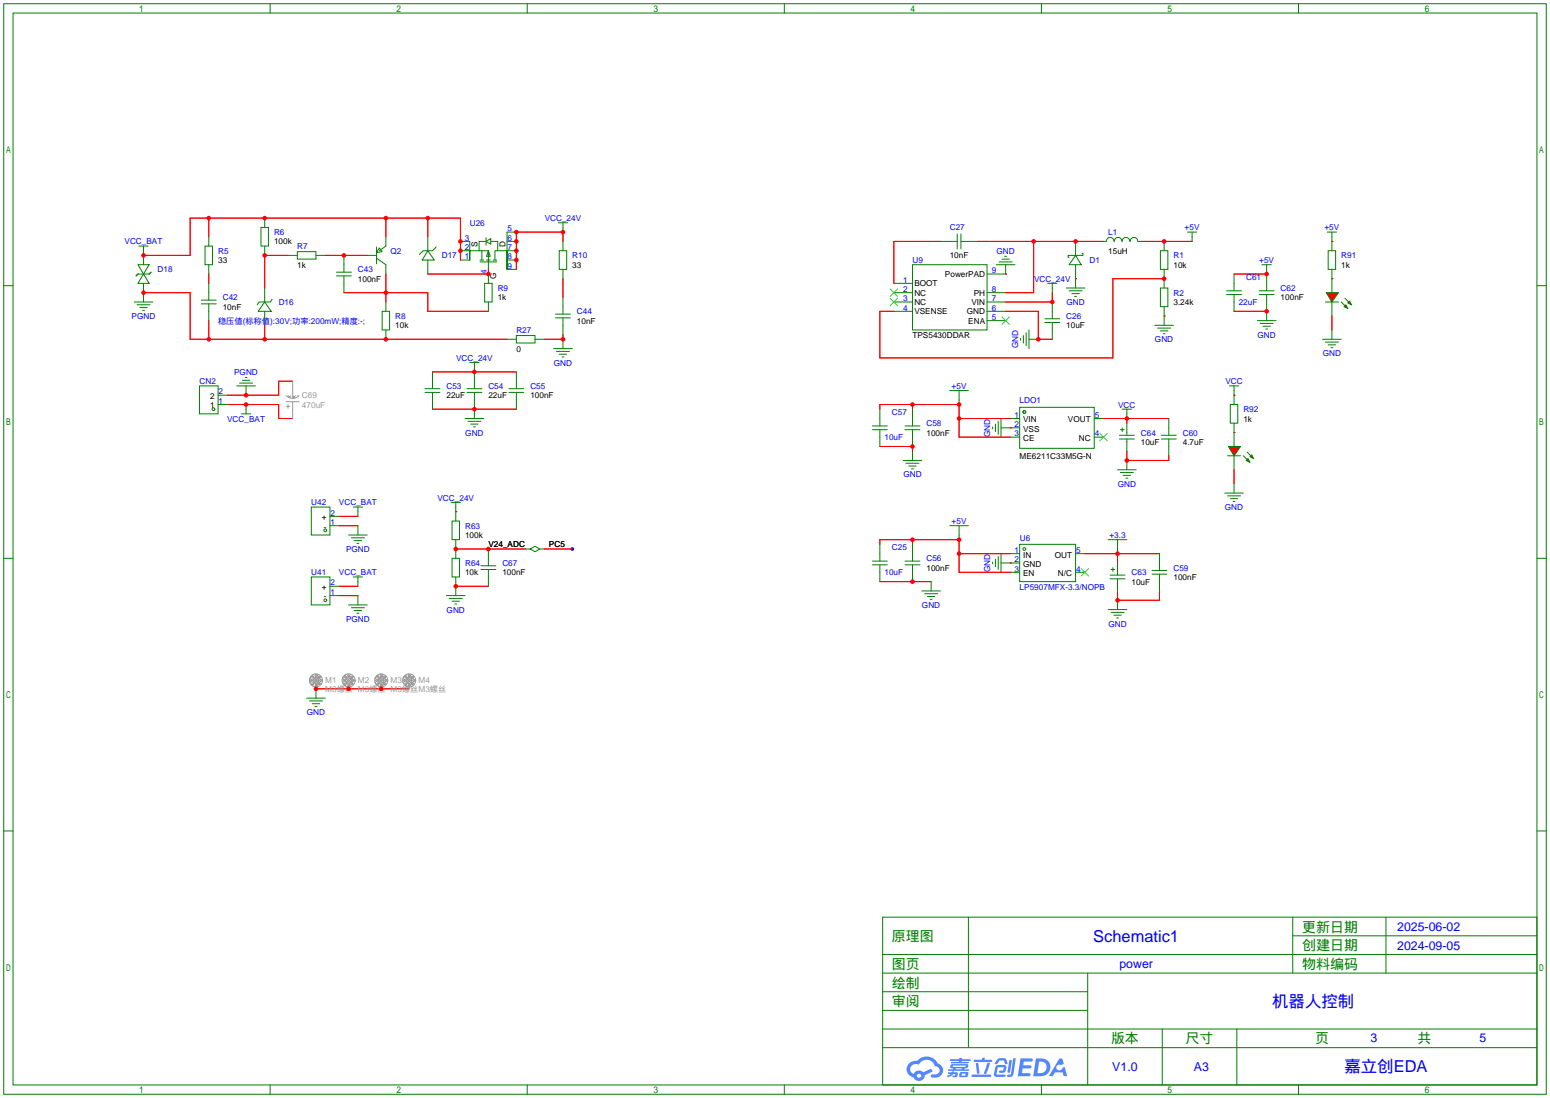
[picture p141: page 3]

稳压值(标称值):30V;功率:200mW;精度:-;

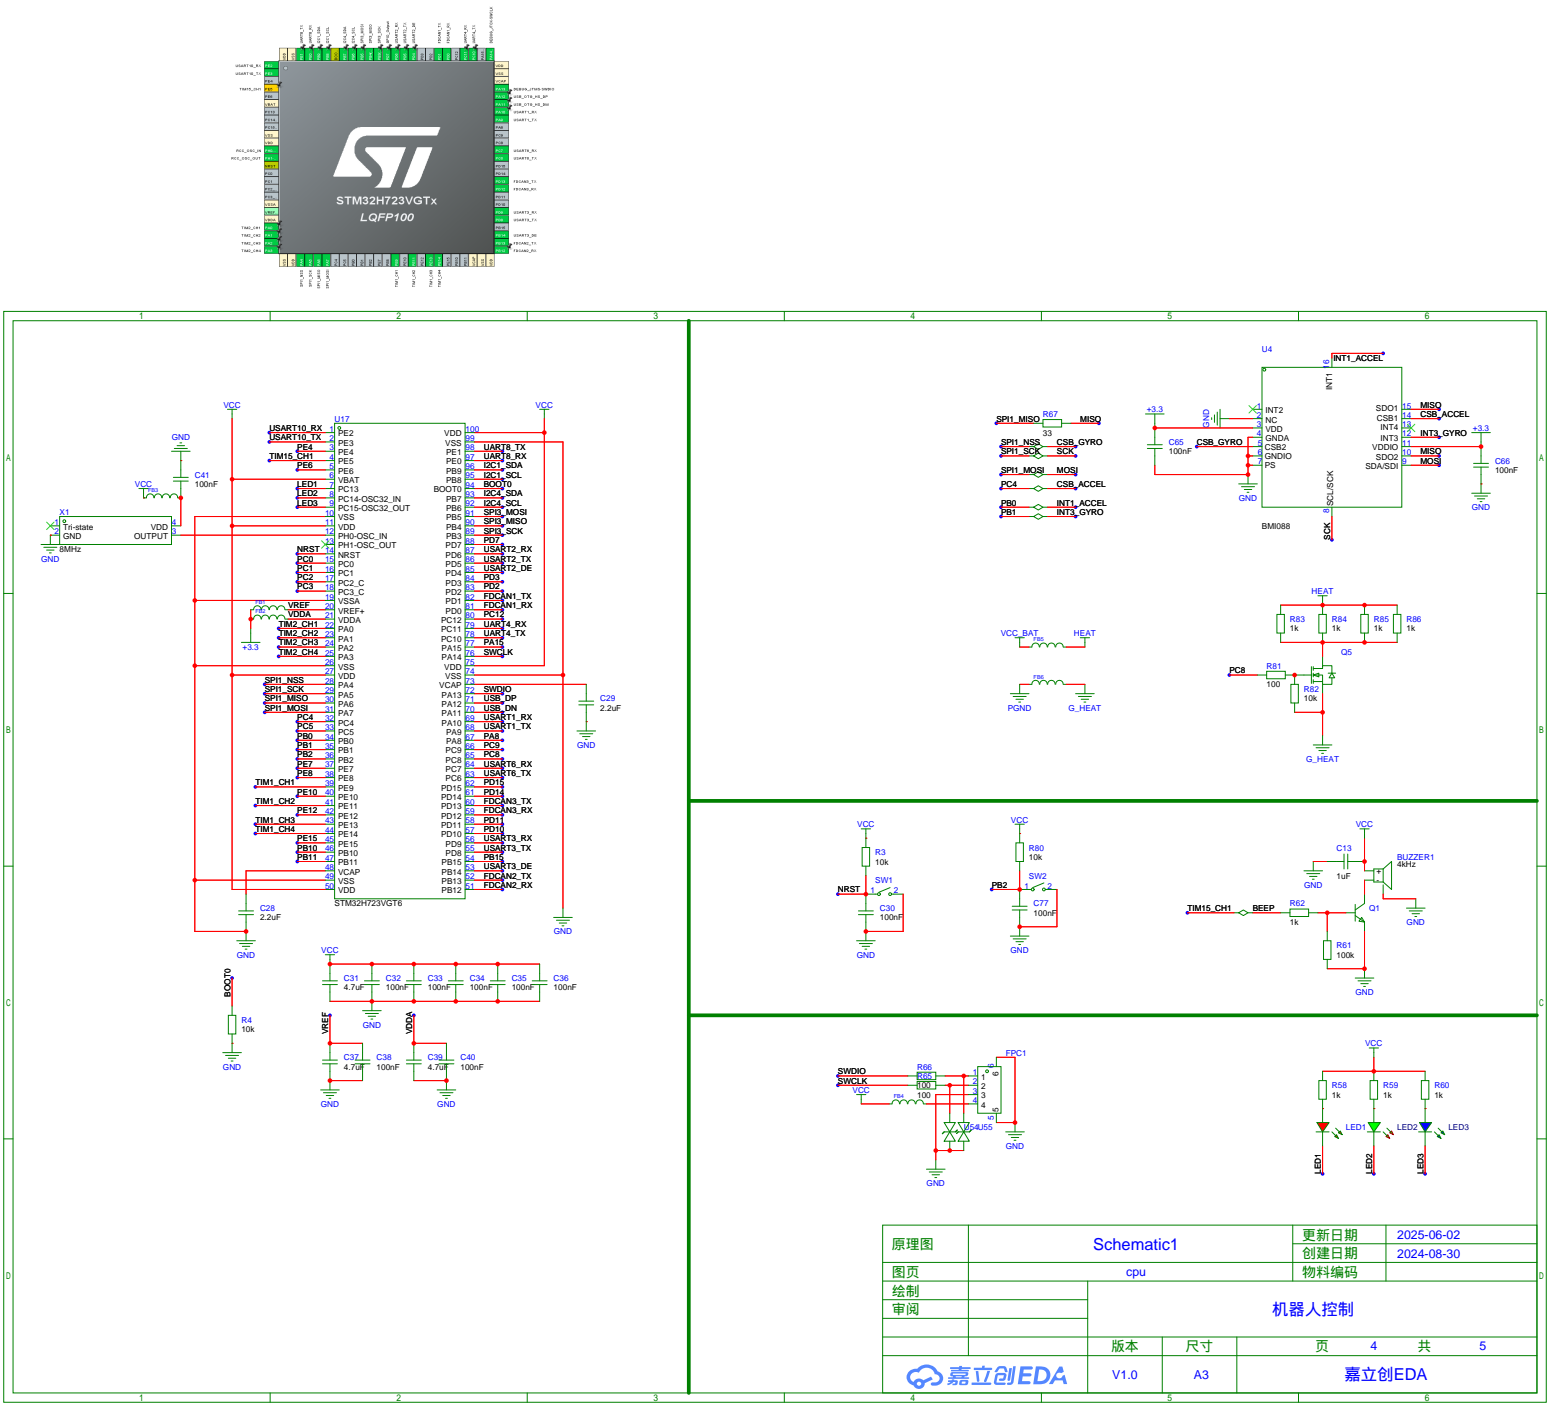
[picture p142: page 4]

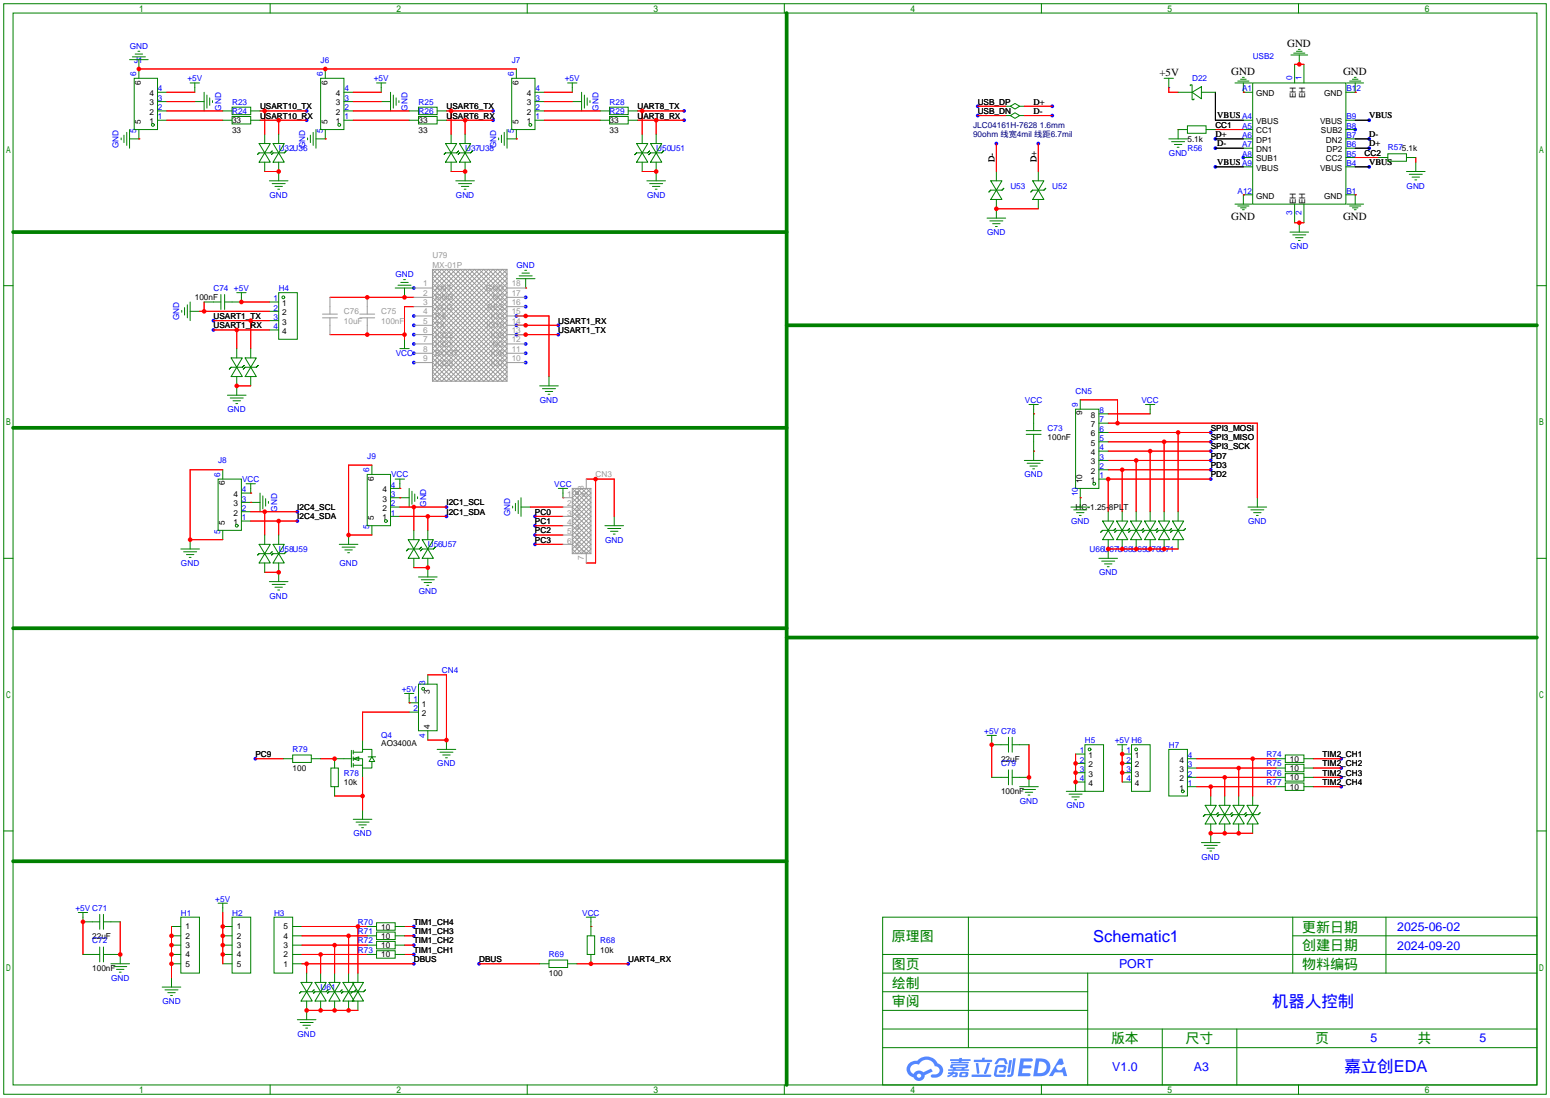
[picture p143: page 5]

GND
IO7 10 IO6 11 NC 12 IO9 13 IO10 14 IO3 15 RES 16 NC 17 GND 18
