Mr-A-urora/mini_wheel_legged_four/finished/hardware/主控PCB.pdf

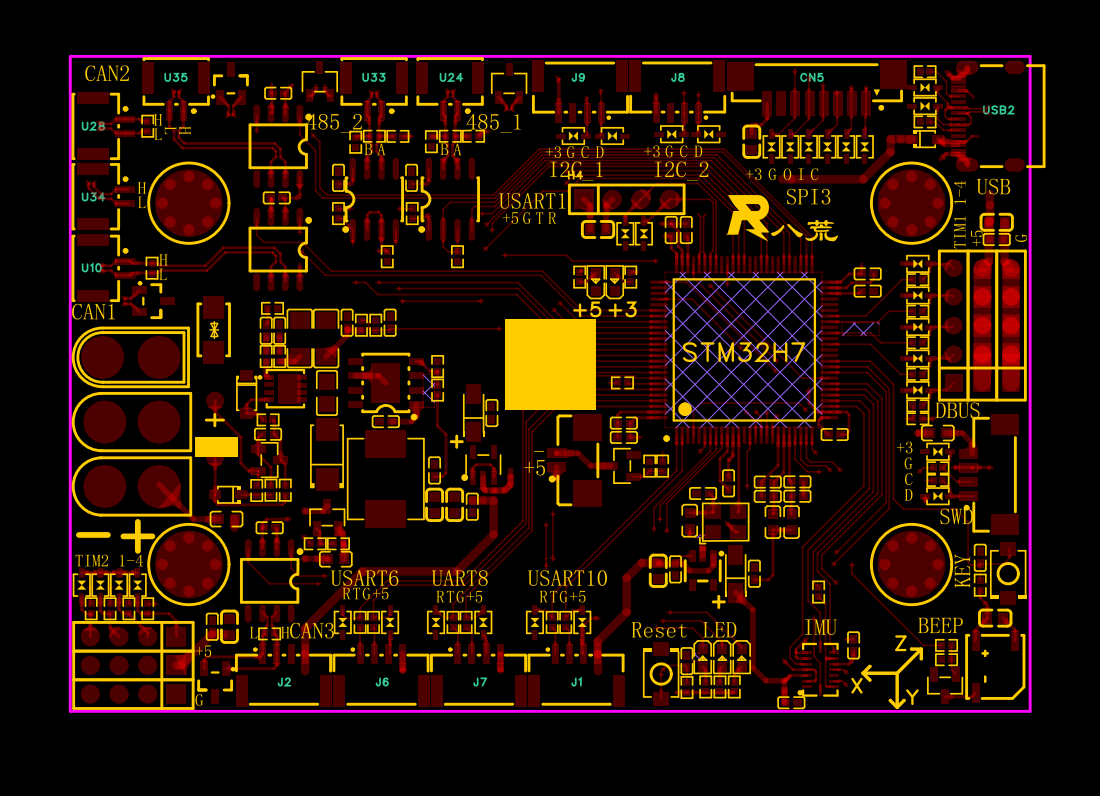
[picture p144: page 1]

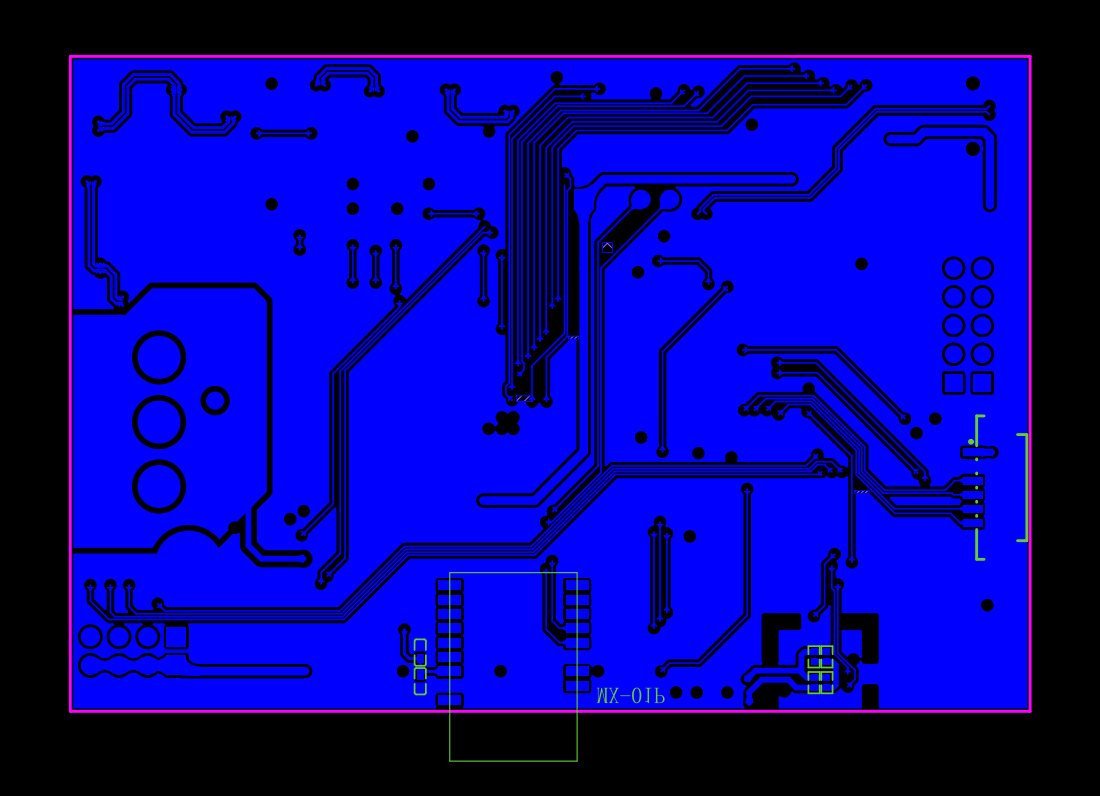
[picture p145: page 2]

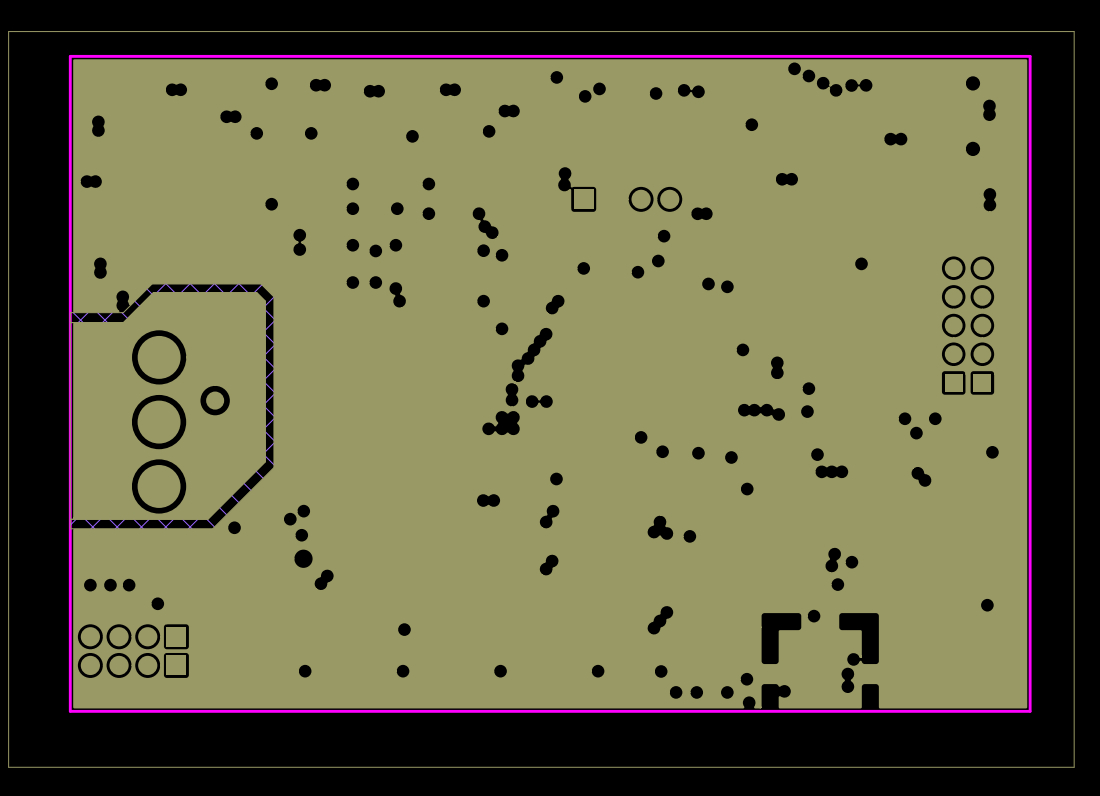
[picture p146: page 3]

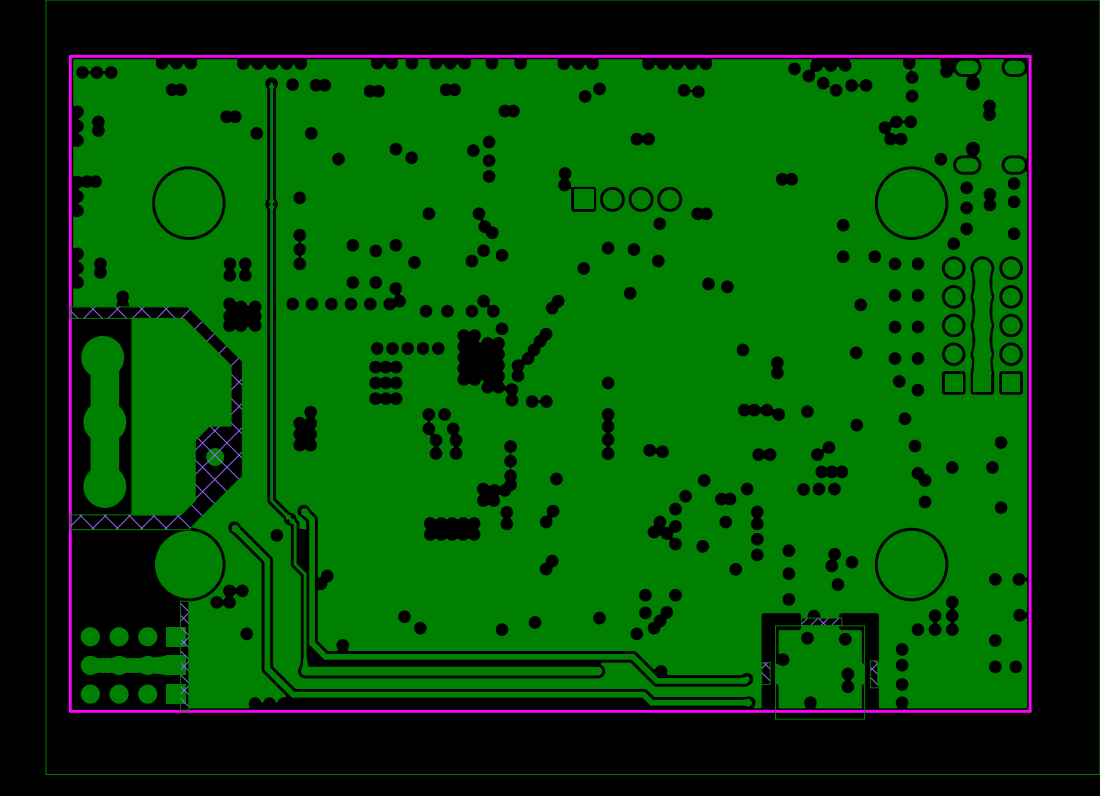
[picture p147: page 4]
