Mr-A-urora/mini_wheel_legged_four/(list of files, drawings)

Other design files:
finished/hardware/esp32c3接收机.epro
finished/hardware/LED_board.epro
finished/hardware/接收机铝基板.epro
