Mr-A-urora/mini_wheel_legged_four/robot_main/robot_main.ioc

Mcu.UserName=STM32H723VGTx
PA1.Signal=S_TIM2_CH2
PA10.Signal=USART1_RX
PA11.Signal=USB_OTG_HS_DM
PA12.Signal=USB_OTG_HS_DP
PA13(JTMS/SWDIO).Signal=DEBUG_JTMS-SWDIO
PA14(JTCK/SWCLK).Signal=DEBUG_JTCK-SWCLK
PA2.Signal=S_TIM2_CH3
PA3.Signal=S_TIM2_CH4
PA4.Signal=GPIO_Output
PA5.Signal=SPI1_SCK
PA6.Signal=SPI1_MISO
PA7.Signal=SPI1_MOSI
PA9.Signal=USART1_TX
PB0.Signal=GPXTI0
PB1.Signal=GPXTI1
PB2.Signal=GPXTI2
PC10.Signal=UART4_TX
PC11.Signal=UART4_RX
PC13.Signal=GPIO_Output
PC14-OSC32_IN.Signal=GPIO_Output
PC15-OSC32_OUT.Signal=GPIO_Output
PC4.Signal=GPIO_Output
PC5.Signal=ADCx_INP8
PD0.Signal=FDCAN1_RX
PD1.Signal=FDCAN1_TX
PE0.Signal=UART8_RX
PE1.Signal=UART8_TX
PE11.Signal=S_TIM1_CH2
PE2.Signal=USART10_RX
PE3.Signal=USART10_TX
PE5.Signal=S_TIM15_CH1
PE9.Signal=S_TIM1_CH1
PH0-OSC_IN.Signal=RCC_OSC_IN
PH1-OSC_OUT.Signal=RCC_OSC_OUT
