Mr-A-urora/mini_wheel_legged_four/robot_main/Core/Src/main.c

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
/* Includes ------------------------------------------------------------------*/
#include "main.h"
#include "cmsis_os.h"
#include "adc.h"
#include "dma.h"
#include "fdcan.h"
#include "spi.h"
#include "tim.h"
#include "usart.h"
#include "usb_device.h"
#include "gpio.h"

/* USER CODE BEGIN Includes */
#include "BMI088driver.h"
#include "kalman_filter.h"
#include "mahony_filter.h"
#include "bsp_dwt.h"
#include "BMI088Middleware.h"
#include "chassis_task.h"
/* USER CODE END Includes */

/* USER CODE BEGIN PM */
uint8_t uart1_rx_buf[100];
uint8_t uart1_rx_ok_flag;
uint8_t uart1_rx_len;
uint8_t rx_buffer[100];
/* USER CODE END PM */


void SystemClock_Config(void);
void MX_FREERTOS_Init(void);
/**
  * @brief  The application entry point.
  * @retval int
  */
int main(void)
{

  /* MCU Configuration--------------------------------------------------------*/

  /* Reset of all peripherals, Initializes the Flash interface and the Systick. */
  HAL_Init();

  /* Configure the system clock */
  SystemClock_Config();

  /* Initialize all configured peripherals */
  MX_GPIO_Init();
  MX_DMA_Init();
  MX_ADC1_Init();
  MX_TIM8_Init();
  MX_UART4_Init();
  MX_USART1_UART_Init();
  MX_TIM15_Init();
  MX_FDCAN1_Init();
  MX_TIM1_Init();
  MX_TIM2_Init();
  MX_UART8_Init();
  MX_USART10_UART_Init();
  MX_SPI1_Init();
  /* USER CODE BEGIN 2 */
	HAL_ADCEx_Calibration_Start(&hadc1, ADC_CALIB_OFFSET_LINEARITY, ADC_SINGLE_ENDED);
  HAL_TIM_PWM_Start(&htim15,TIM_CHANNEL_1);
  __HAL_UART_ENABLE_IT(&huart1, UART_IT_IDLE);  
  HAL_UART_Receive_DMA(&huart1, uart1_rx_buf, 100);  
  __HAL_UART_ENABLE_IT(&huart4, UART_IT_IDLE);  
  HAL_UART_Receive_DMA(&huart4, rx_buffer, 100); 

  DWT_Init(550);
  while (BMI088_init(&hspi1, 0) != BMI088_NO_ERROR)
	{
	  ;
	}

  /* USER CODE END 2 */

  /* Init scheduler */
  osKernelInitialize();

  /* Call init function for freertos objects (in cmsis_os2.c) */
  MX_FREERTOS_Init();

  /* Start scheduler */
  osKernelStart();

  /* We should never get here as control is now taken by the scheduler */

  /* Infinite loop */
  /* USER CODE BEGIN WHILE */
  while (1)
  {
    /* USER CODE END WHILE */

    /* USER CODE BEGIN 3 */

  }
  /* USER CODE END 3 */
}

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
/**
  * @brief  Period elapsed callback in non blocking mode
  * @note   This function is called  when TIM6 interrupt took place, inside
  * HAL_TIM_IRQHandler(). It makes a direct call to HAL_IncTick() to increment
  * a global variable "uwTick" used as application time base.
  * @param  htim : TIM handle
  * @retval None
  */
void HAL_TIM_PeriodElapsedCallback(TIM_HandleTypeDef *htim)
{
  if (htim->Instance == TIM6) {
    HAL_IncTick();
  }
}

/**
  * @brief  This function is executed in case of error occurrence.
  * @retval None
  */
void Error_Handler(void)
{
  /* USER CODE BEGIN Error_Handler_Debug */
  /* User can add his own implementation to report the HAL error return state */
  __disable_irq();
  while (1)
  {
  }
  /* USER CODE END Error_Handler_Debug */
}

#ifdef  USE_FULL_ASSERT
/**
  * @brief  Reports the name of the source file and the source line number
  *         where the assert_param error has occurred.
  * @param  file: pointer to the source file name
  * @param  line: assert_param error line source number
  * @retval None
  */
void assert_failed(uint8_t *file, uint32_t line)
{
  /* USER CODE BEGIN 6 */
  /* User can add his own implementation to report the file name and line number,
     ex: printf("Wrong parameters value: file %s on line %d\r\n", file, line) */
  /* USER CODE END 6 */
}
#endif /* USE_FULL_ASSERT */
