Mr-A-urora/mini_wheel_legged_four/robot_main/Core/Work/APP/Inc/observe_task.h

#ifndef __OBSERVE_TASK_H
#define __OBSERVE_TASK_H


#include "main.h"
#include "kalman_filter.h"


extern void Observe_task(void);
extern void xvEstimateKF_Init(KalmanFilter_t *EstimateKF);
extern void xvEstimateKF_Update(KalmanFilter_t *EstimateKF ,float acc,float vel);

#endif
