Mr-A-urora/mini_wheel_legged_four/(commit log)

2026-03-30 依旧有问题
2026-03-31 调参初识！
2026-04-02 调参没头绪
2026-05-02 wheel is slow!
2026-05-03 ID 写反了
