Mr-A-urora/mini_wheel_legged_four/(notices)

Notices in the files:
robot_main/Core/Src/main.c:
Copyright (c) 2024 STMicroelectronics.
All rights reserved.
This software is licensed under terms that can be found in the LICENSE file
